JuanCozzi/Trabajo_Final/Informes/propuesta/Imagenes/control_wifi_riego_hunter.PNG

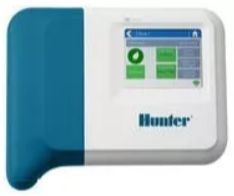
Informes/propuesta/Imagenes/control_wifi_riego_hunter.PNG
