JuanCozzi/Trabajo_Final/Informes/propuesta/Imagenes/modulo_entradas_analogicas.PNG

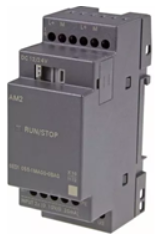
Informes/propuesta/Imagenes/modulo_entradas_analogicas.PNG
