JuanCozzi/Trabajo_Final/README.md

# Trabajo_Final

Trabajo final de Ingeniería Electrónica, Facultad de Ing. UBA

Control de minipiscinas 

Integrantes:
            Bourbon, Rodrigo
            Cozzi, Juan Ignacio
