JuanCozzi/Trabajo_Final/Implementacion/Hardware/pines.jpg

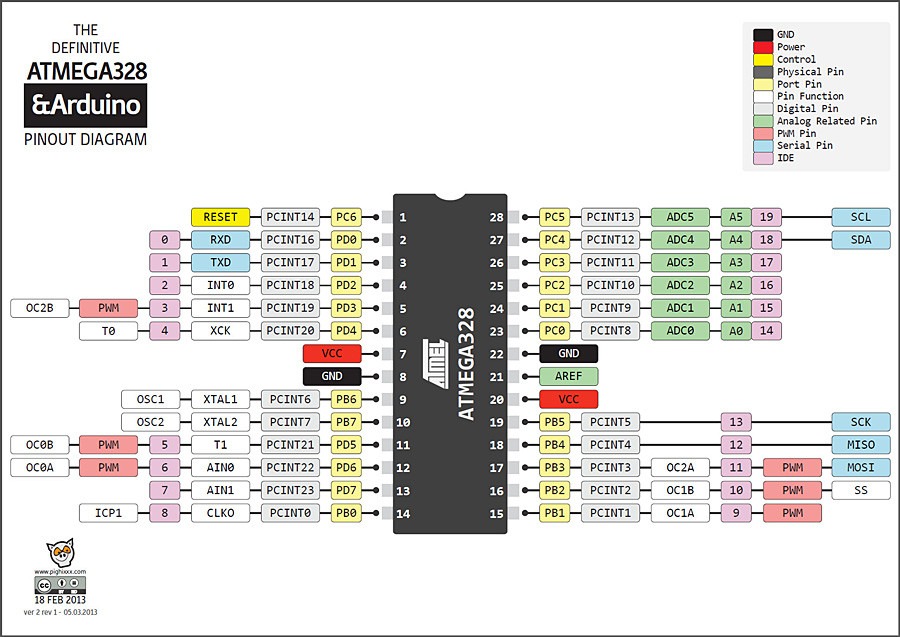
Implementacion/Hardware/pines.jpg
