JuanCozzi/Trabajo_Final/Informes/Imagenes/Final/Bloque_hardware.png

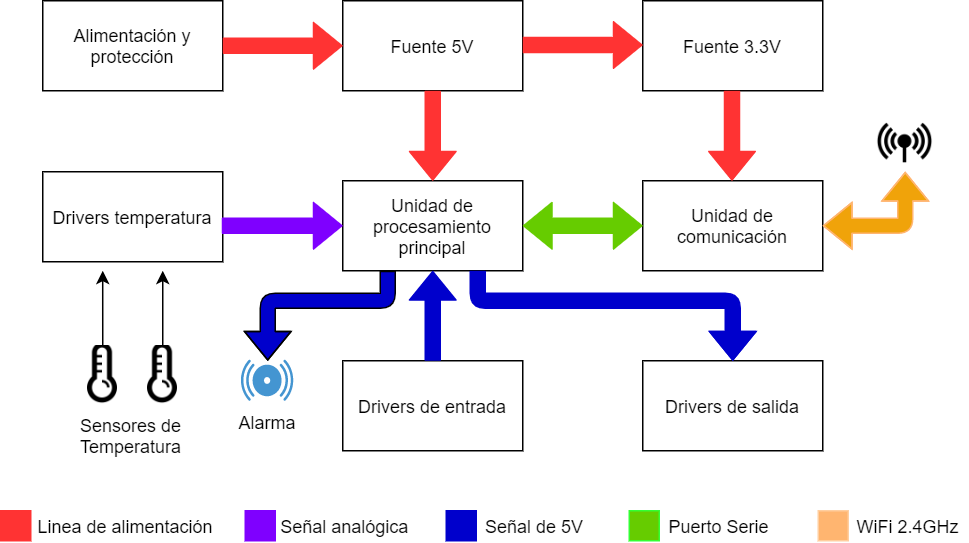
Informes/Imagenes/Final/Bloque_hardware.png
