JuanCozzi/Trabajo_Final/Informes/Imagenes/Final/draw.io/diagrama_flujo_unidad_comunicacion.png

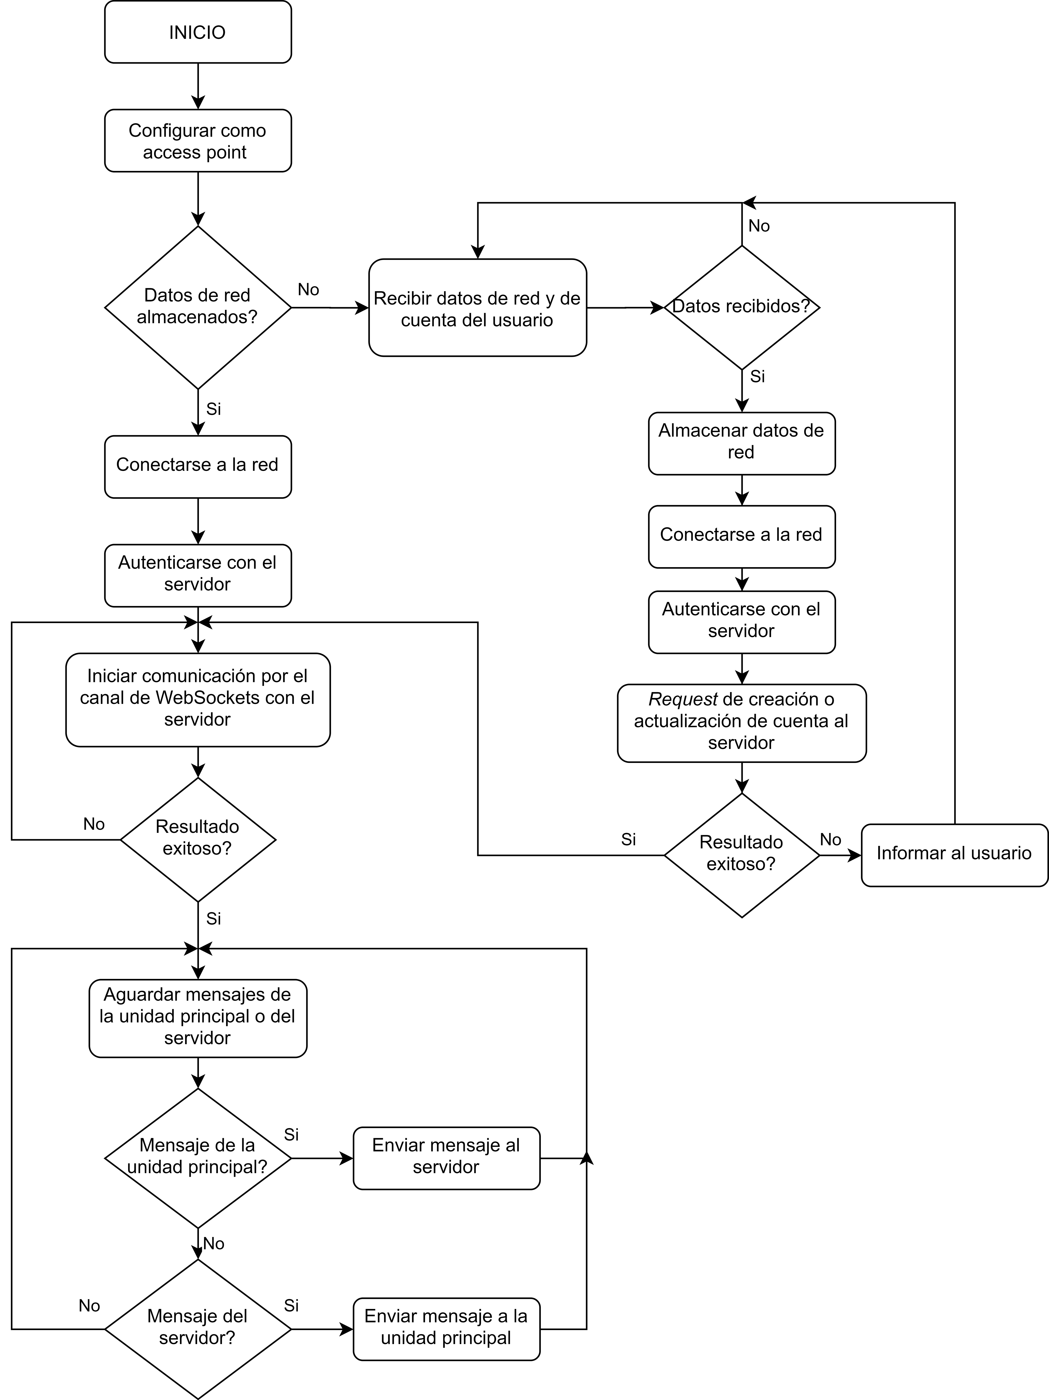
Informes/Imagenes/Final/draw.io/diagrama_flujo_unidad_comunicacion.png
