JuanCozzi/Trabajo_Final/Informes/Imagenes/Final/draw.io/diagrama_flujo_unidad_principal.png

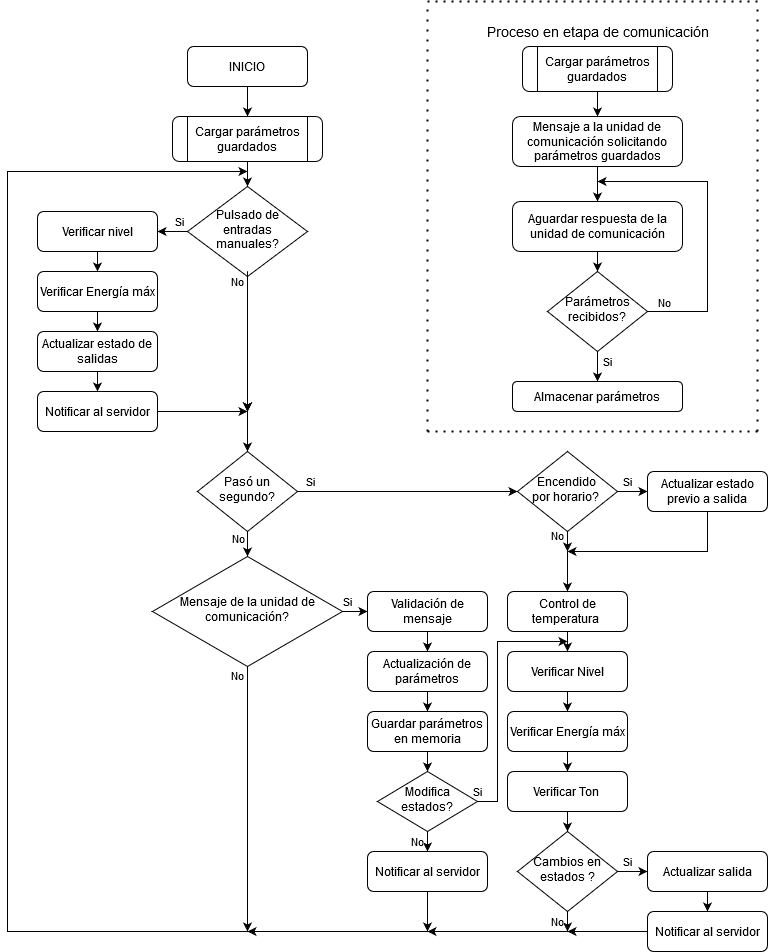
Informes/Imagenes/Final/draw.io/diagrama_flujo_unidad_principal.png
