JuanCozzi/Trabajo_Final/Informes/Imagenes/Final/draw.io/Secuencia2.jpg

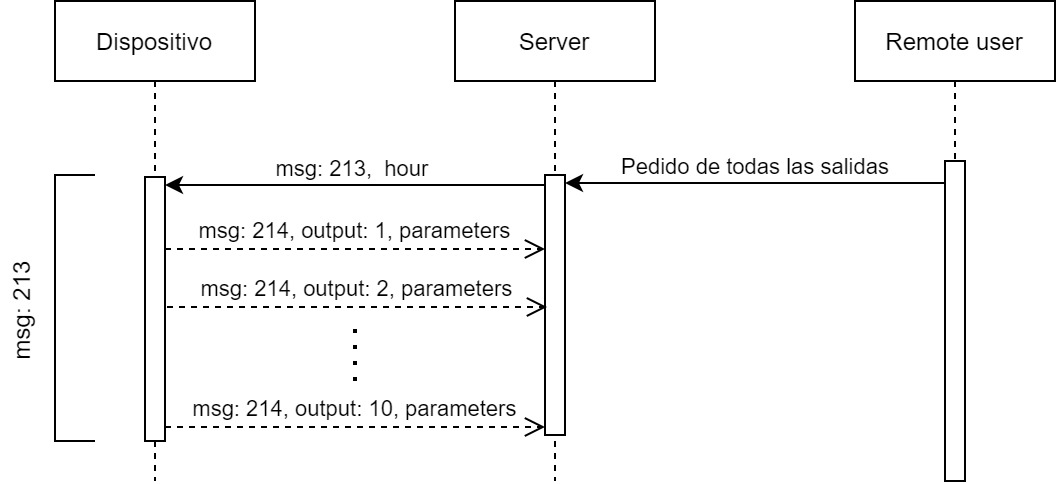
Informes/Imagenes/Final/draw.io/Secuencia2.jpg
