JuanCozzi/Trabajo_Final/Informes/Imagenes/Final/draw.io/Secuencia4.jpg

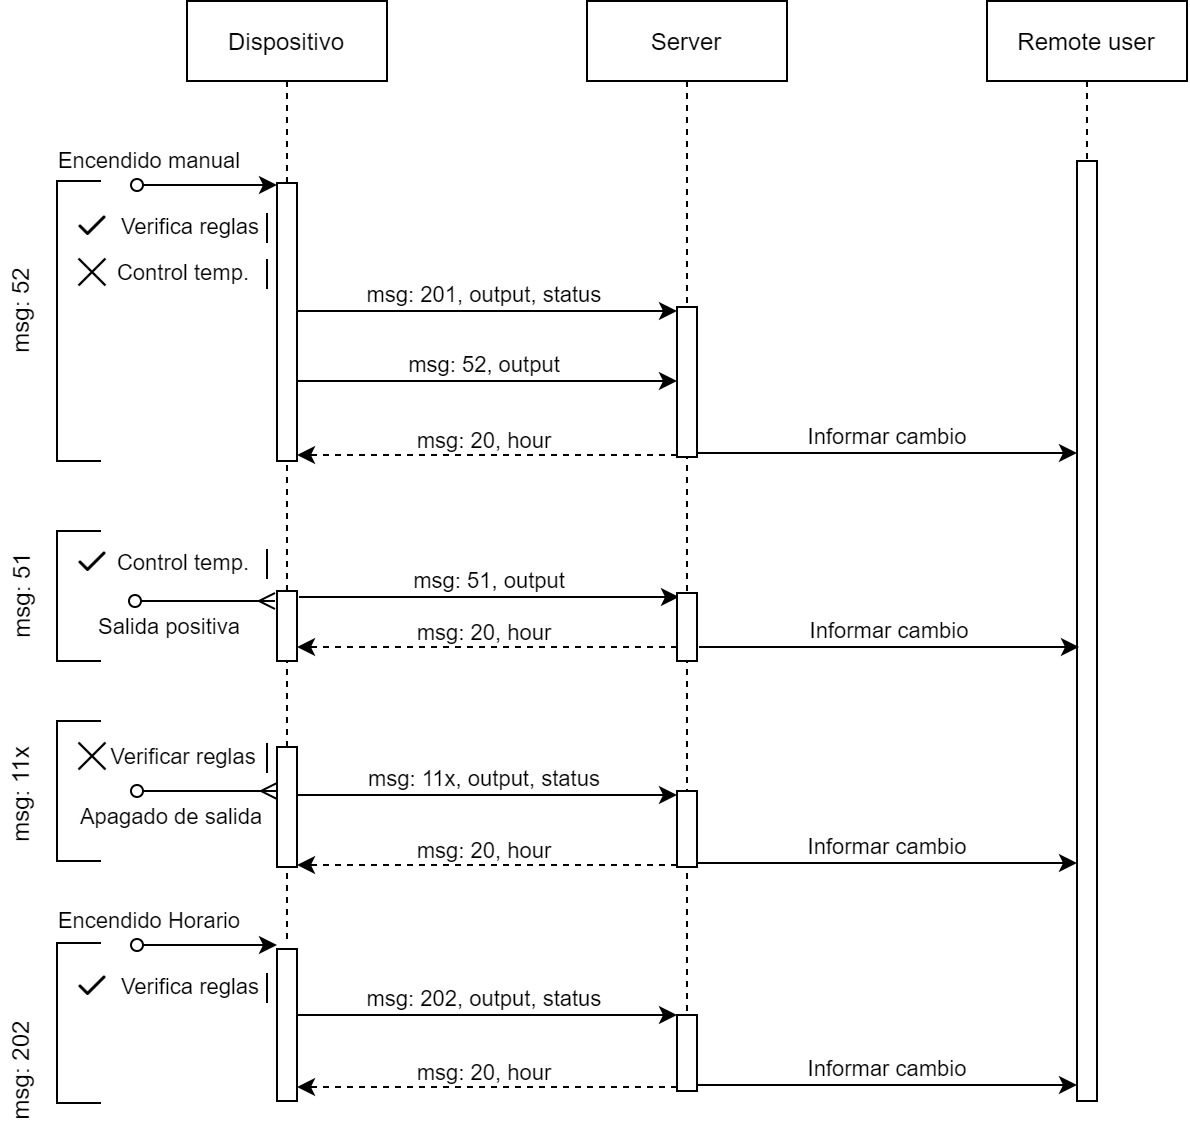
Informes/Imagenes/Final/draw.io/Secuencia4.jpg
