JuanCozzi/Trabajo_Final/Informes/Imagenes/Final/draw.io/Secuencia.jpg

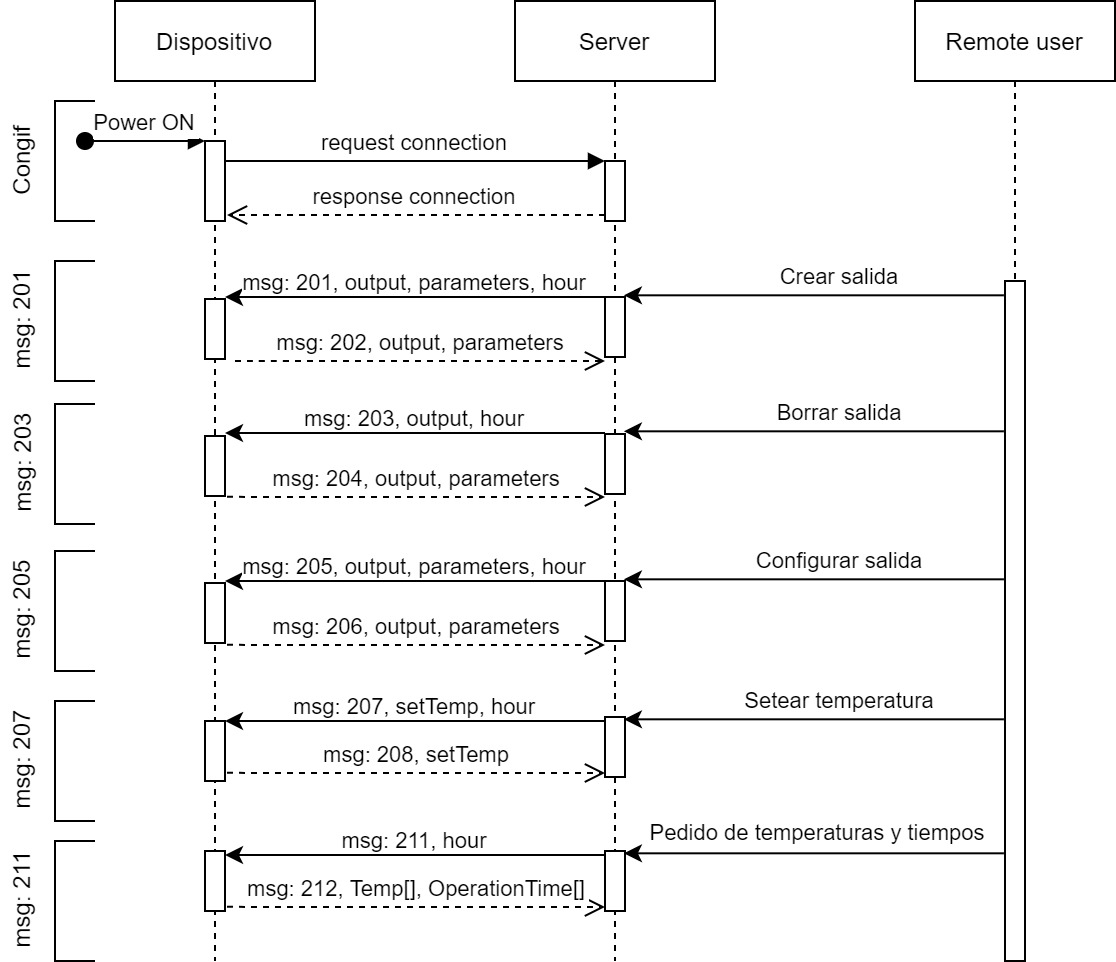
Informes/Imagenes/Final/draw.io/Secuencia.jpg
