JuanCozzi/Trabajo_Final/Informes/Imagenes/Final/draw.io/secuencia_mensajes.png

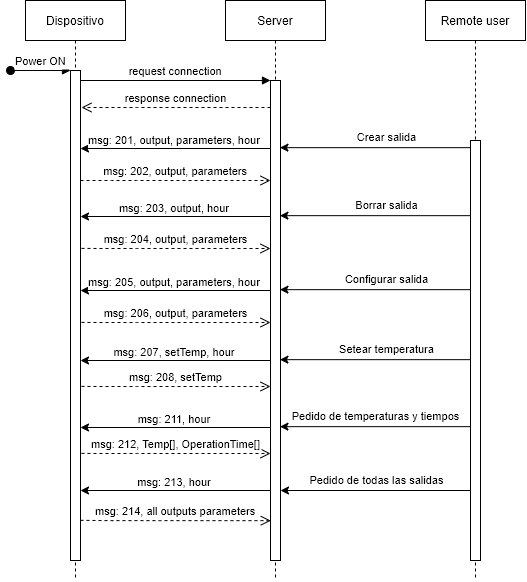
Informes/Imagenes/Final/draw.io/secuencia_mensajes.png
