JuanCozzi/Trabajo_Final/Informes/Imagenes/Final/esquematicos/Atmega.jpg

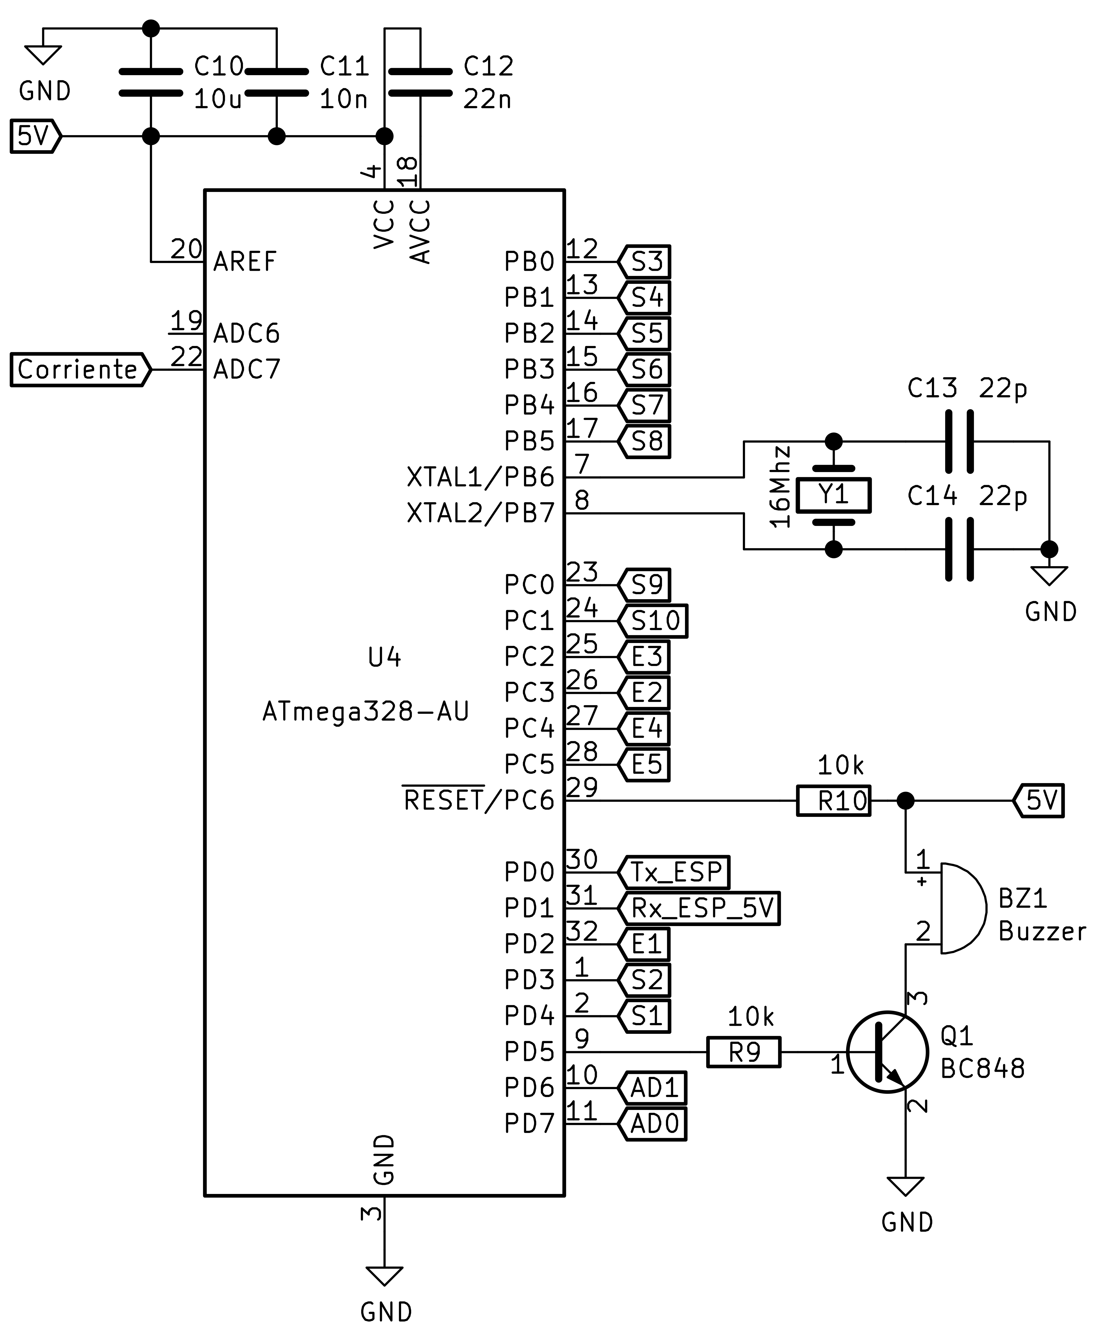
Informes/Imagenes/Final/esquematicos/Atmega.jpg
