JuanCozzi/Trabajo_Final/Informes/Imagenes/Final/esquematicos/Bornera.jpg

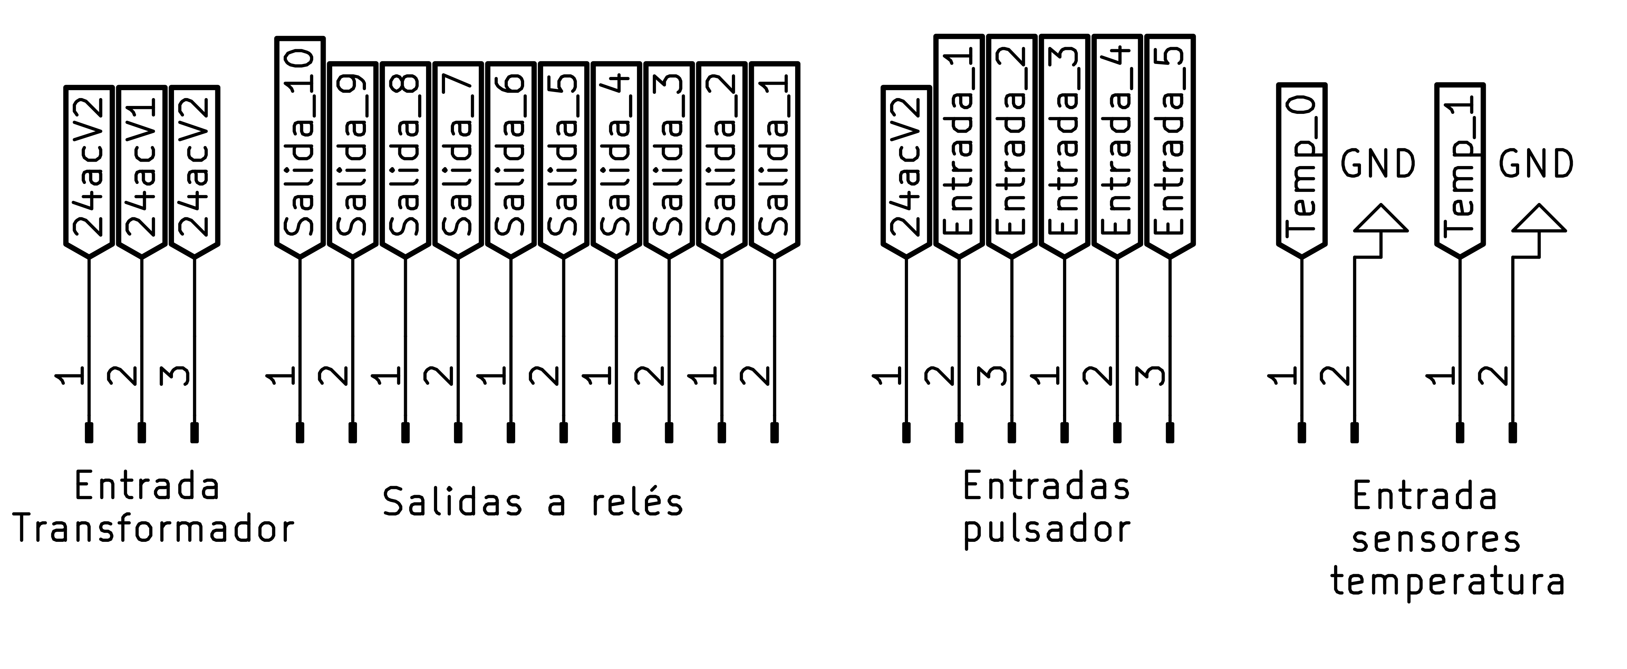
Informes/Imagenes/Final/esquematicos/Bornera.jpg
