JuanCozzi/Trabajo_Final/Informes/Imagenes/Final/esquematicos/Driver_entrada.jpg

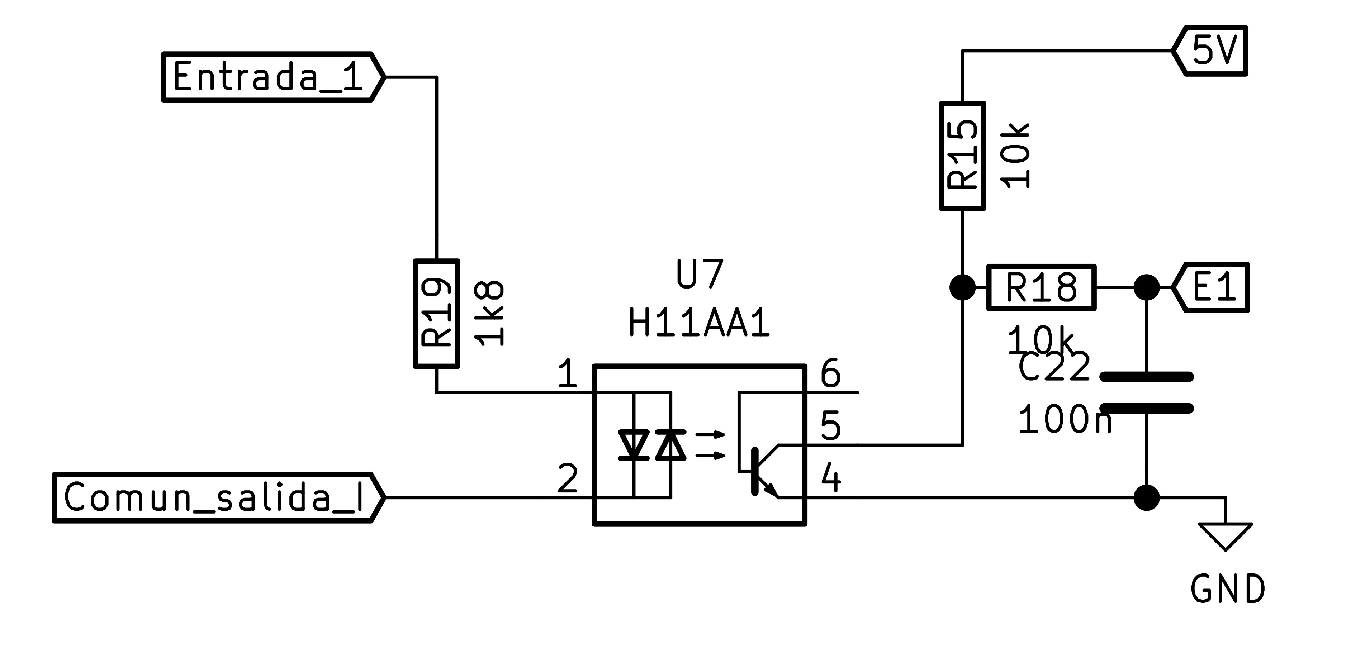
Informes/Imagenes/Final/esquematicos/Driver_entrada.jpg
