JuanCozzi/Trabajo_Final/Informes/Imagenes/Final/esquematicos/Driver_salida.jpg

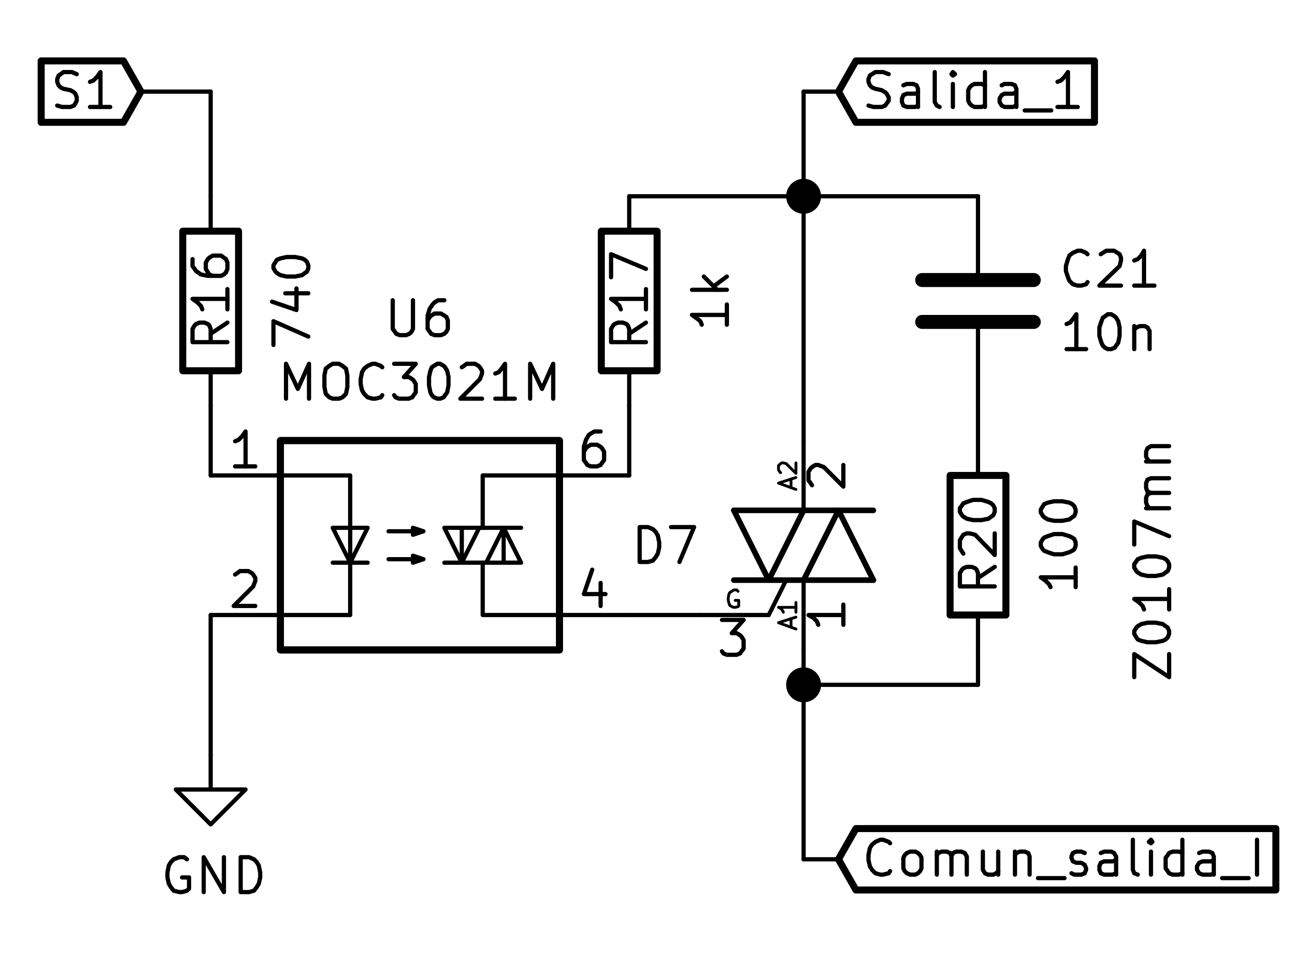
Informes/Imagenes/Final/esquematicos/Driver_salida.jpg
