JuanCozzi/Trabajo_Final/Informes/Imagenes/Final/esquematicos/Esp.jpg

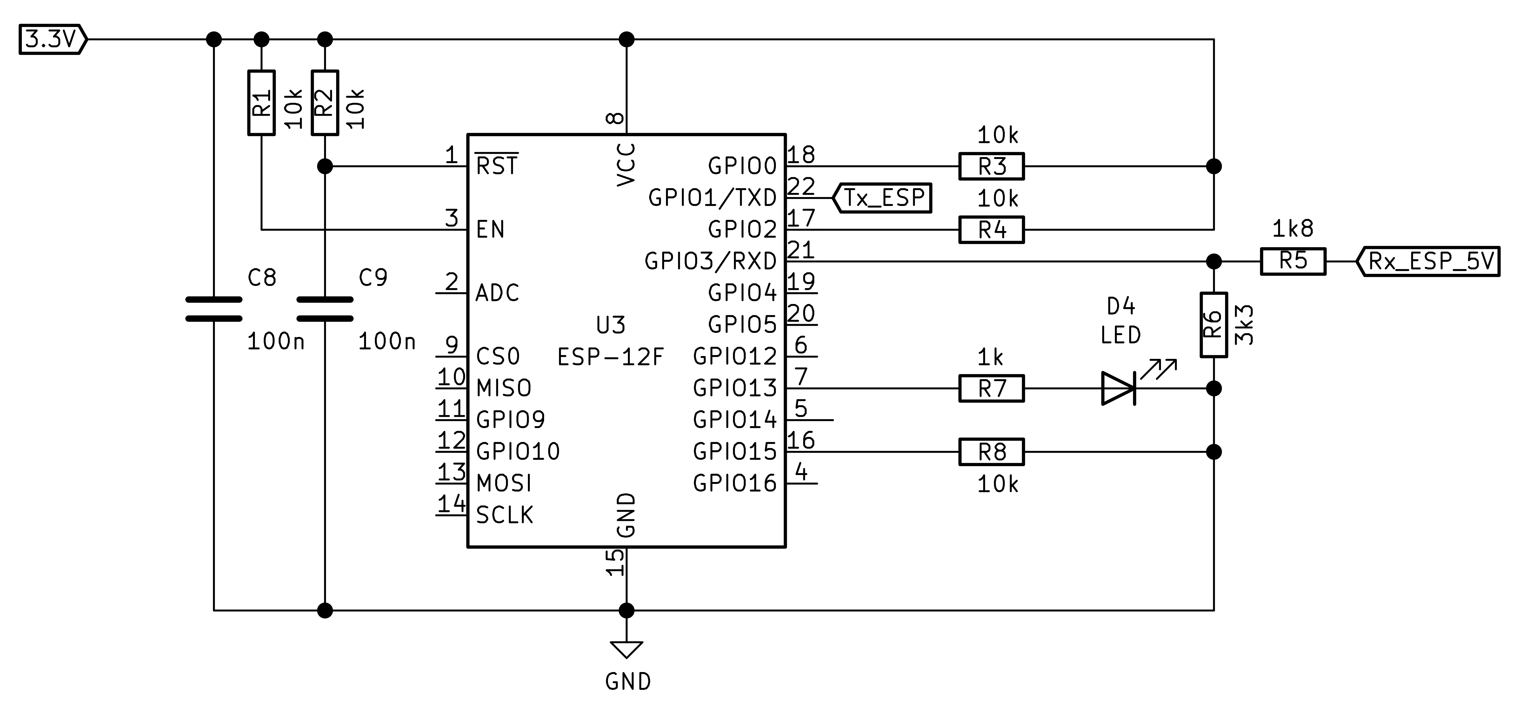
Informes/Imagenes/Final/esquematicos/Esp.jpg
