JuanCozzi/Trabajo_Final/Informes/Imagenes/Final/esquematicos/Fuente.jpg

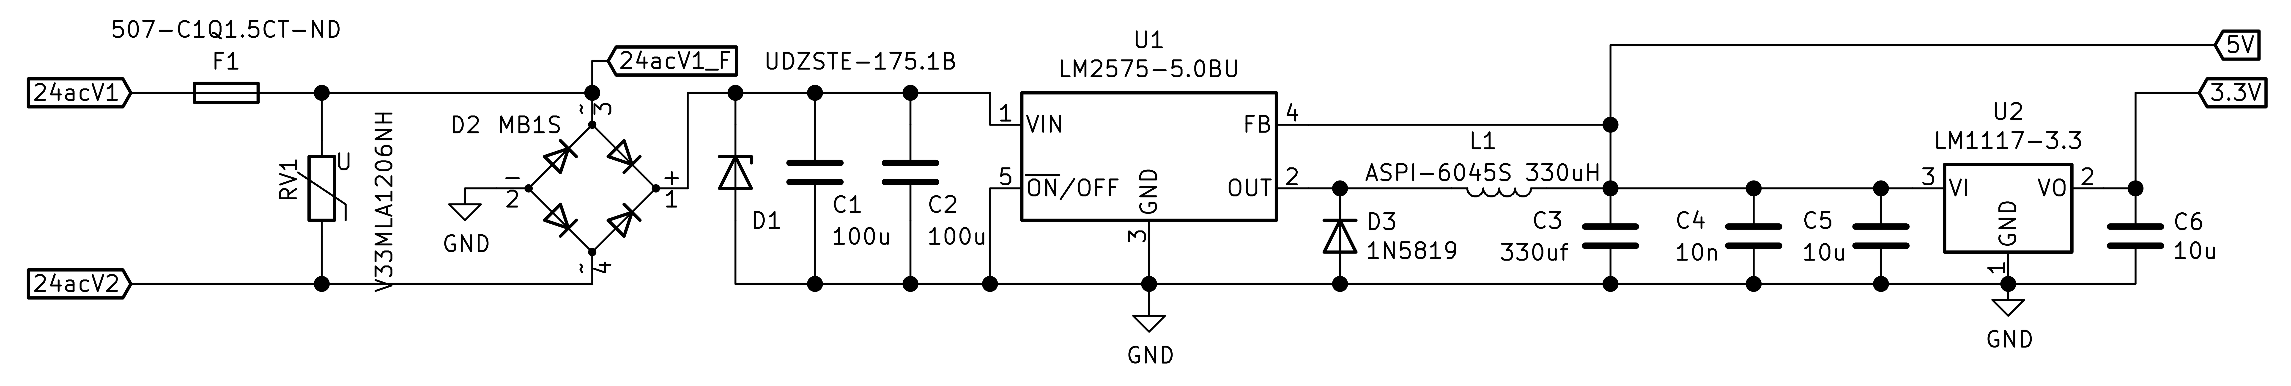
Informes/Imagenes/Final/esquematicos/Fuente.jpg
