JuanCozzi/Trabajo_Final/Informes/Imagenes/Final/esquematicos/Protección.jpg

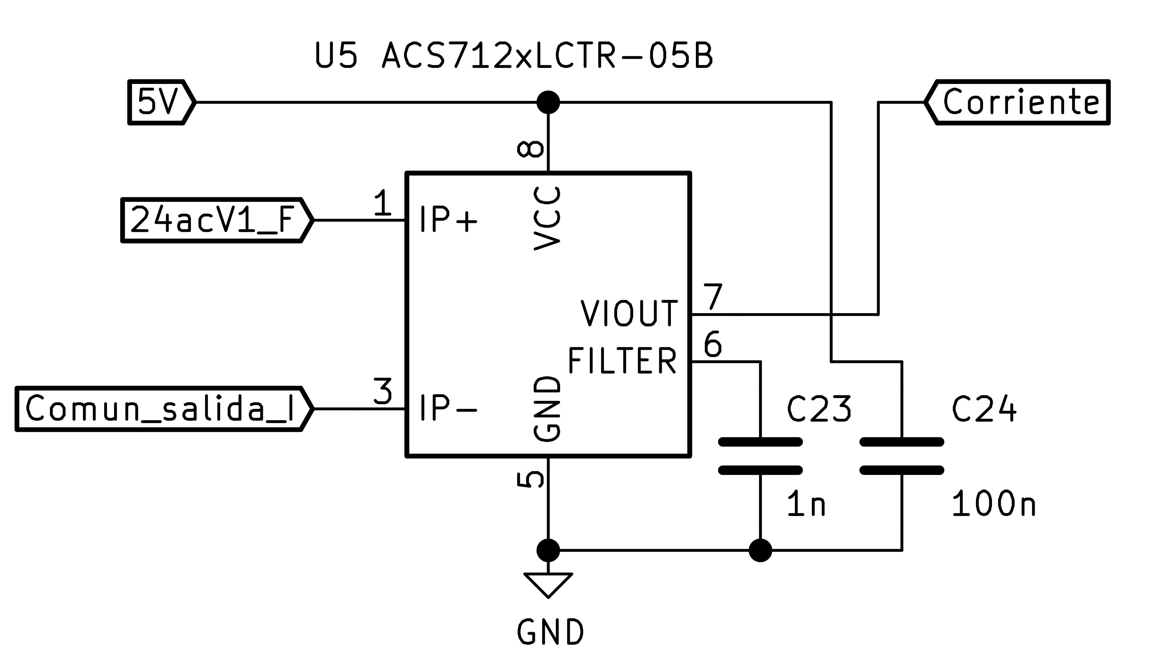
Informes/Imagenes/Final/esquematicos/Protección.jpg
