JuanCozzi/Trabajo_Final/Informes/Imagenes/Final/esquematicos/Temp.jpg

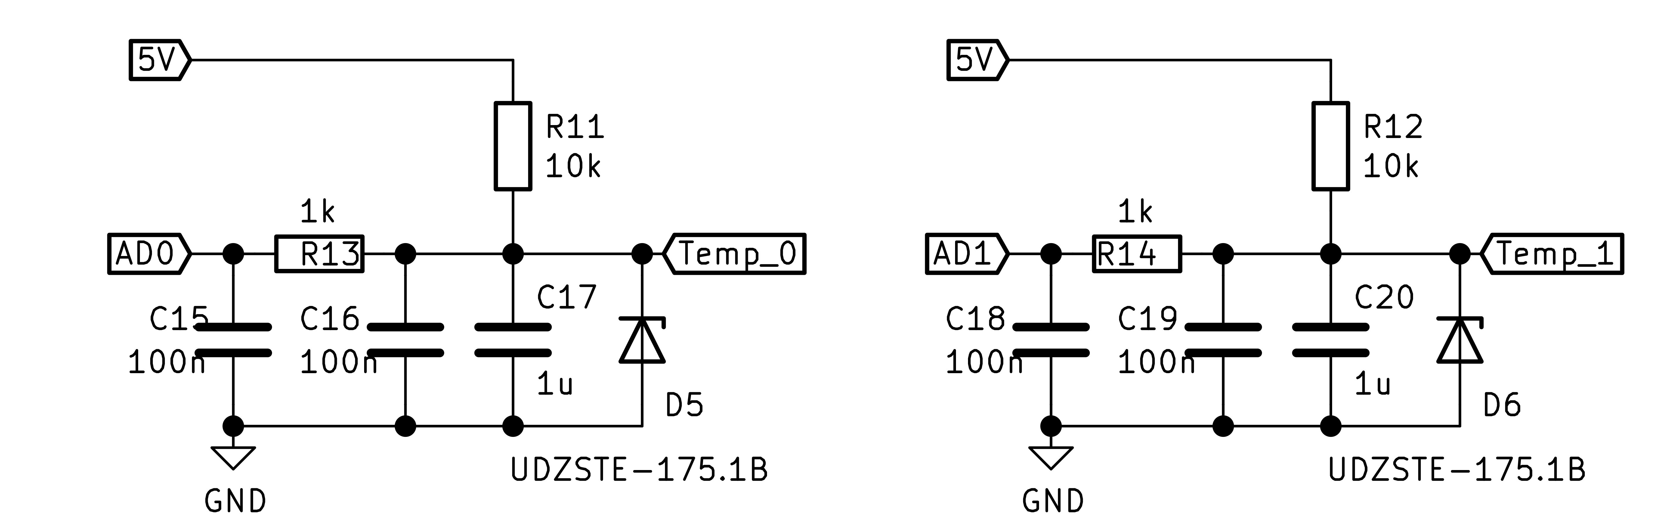
Informes/Imagenes/Final/esquematicos/Temp.jpg
