JuanCozzi/Trabajo_Final/Informes/Imagenes/Final/PCB/3D.jpg

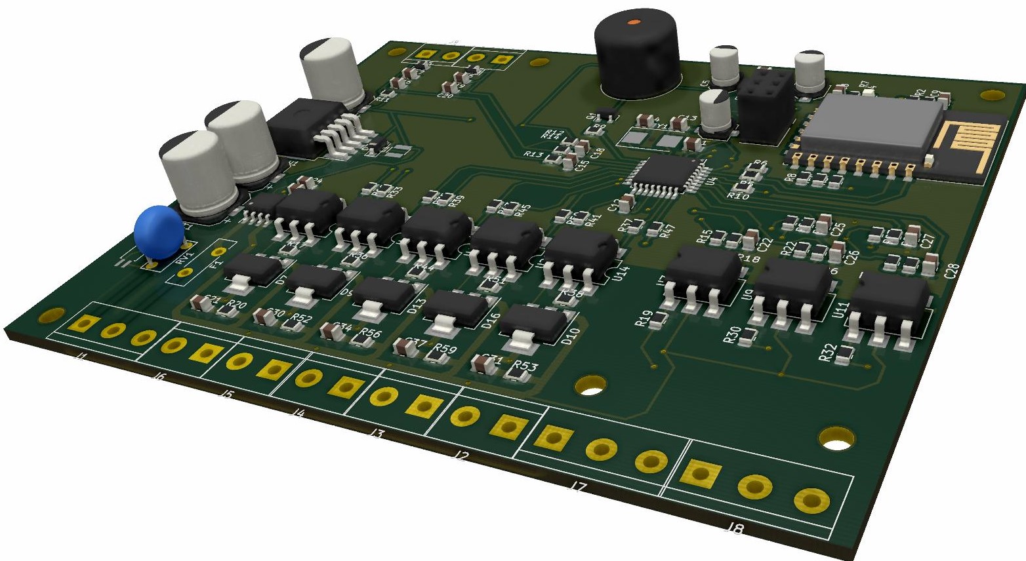
Informes/Imagenes/Final/PCB/3D.jpg
