JuanCozzi/Trabajo_Final/Informes/Imagenes/Final/PCB/Final_1-B_Cu.jpg

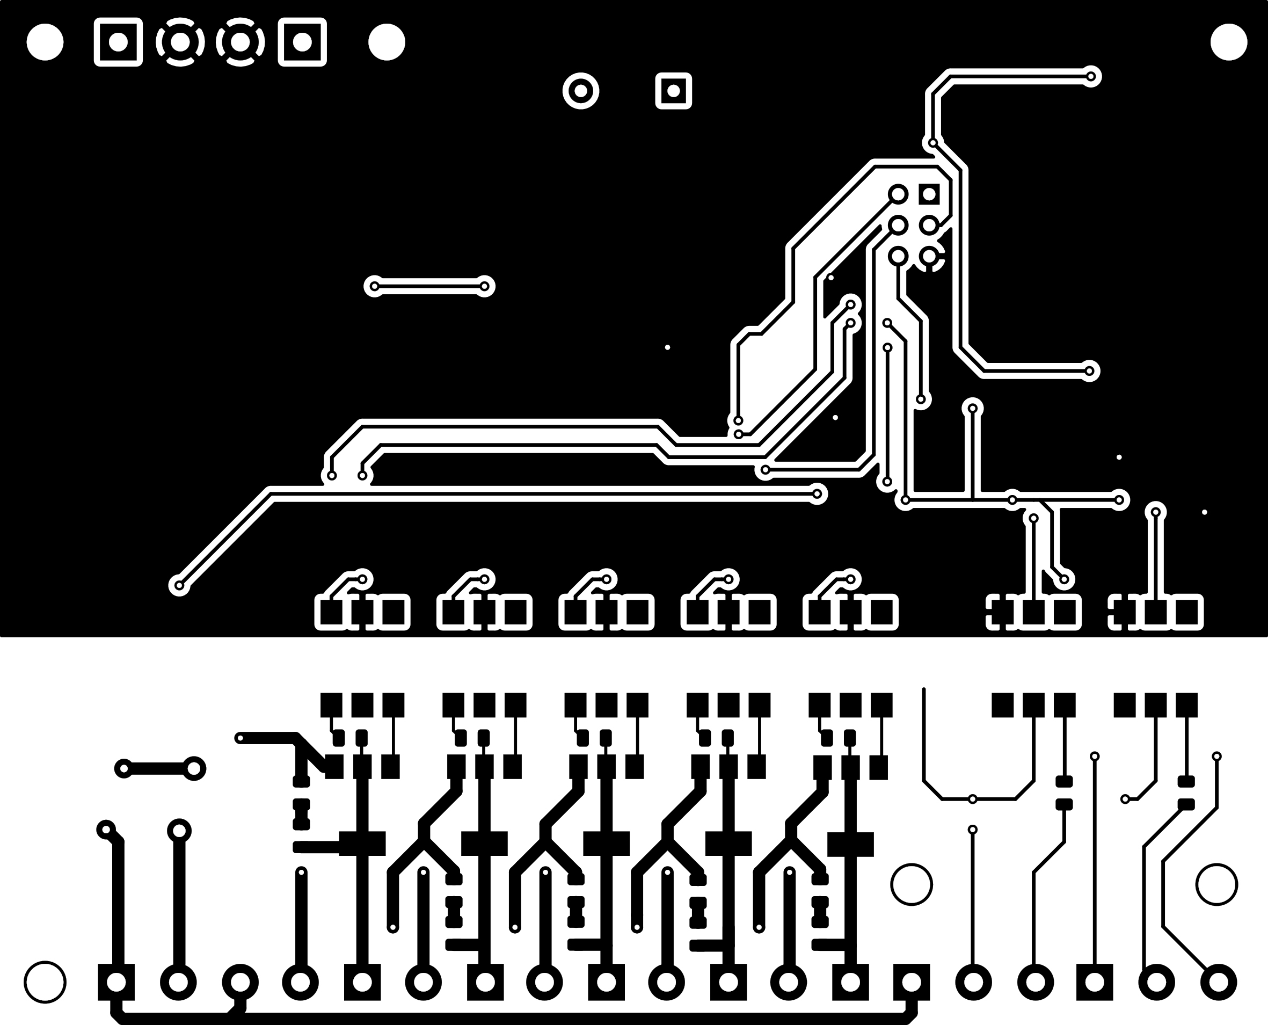
Informes/Imagenes/Final/PCB/Final_1-B_Cu.jpg
