JuanCozzi/Trabajo_Final/Informes/Imagenes/Final/PCB/Final_1-F_Cu.jpg

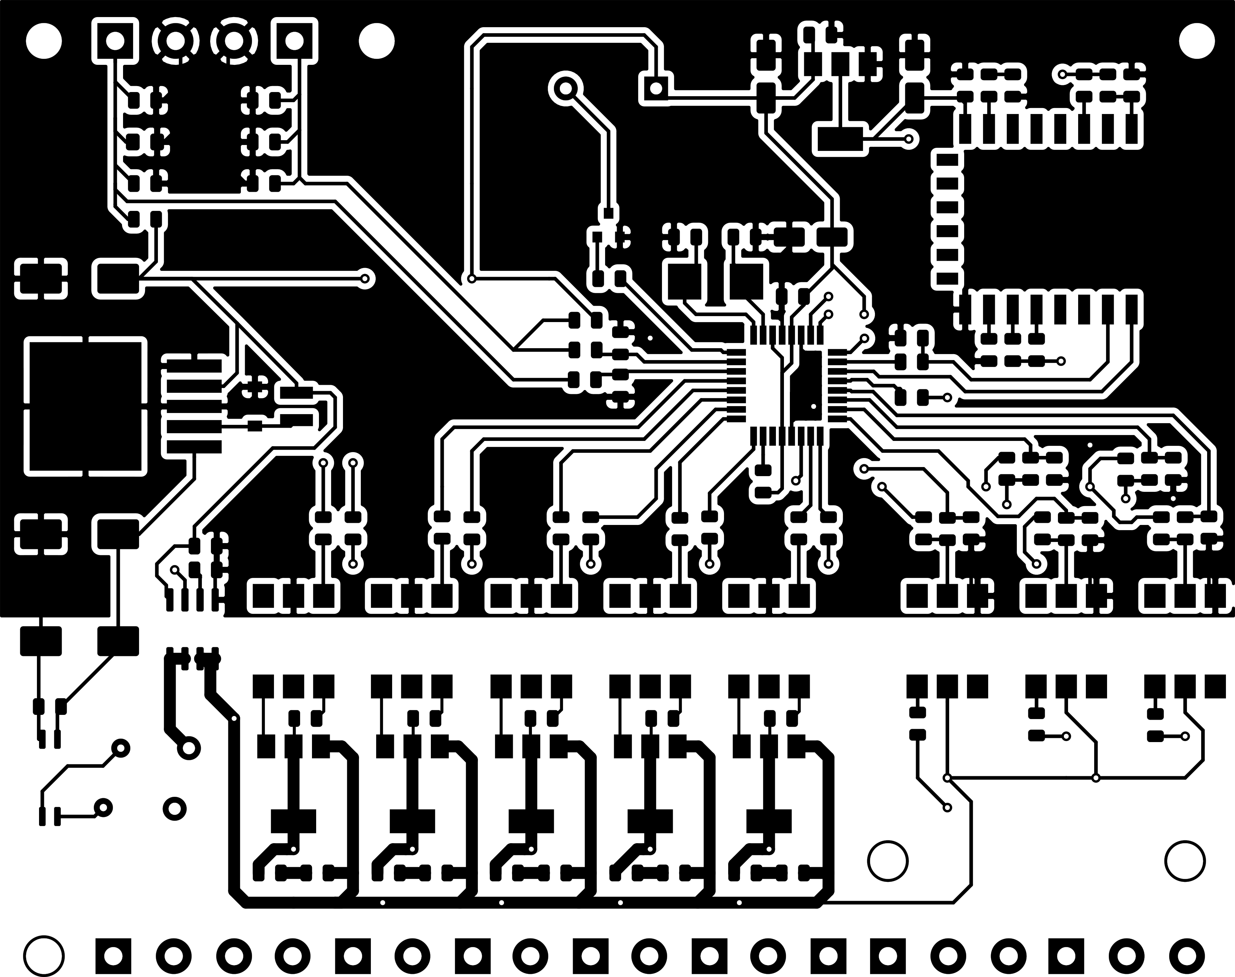
Informes/Imagenes/Final/PCB/Final_1-F_Cu.jpg
