JuanCozzi/Trabajo_Final/Informes/propuesta/Imagenes/ciclo_vida.PNG

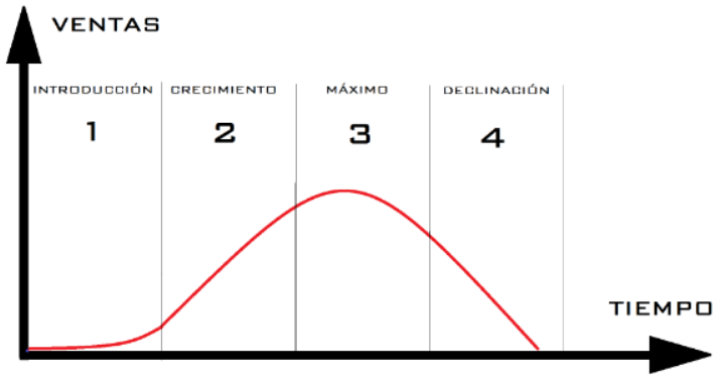
Informes/propuesta/Imagenes/ciclo_vida.PNG
