JuanCozzi/Trabajo_Final/Informes/propuesta/Imagenes/control_riego_hunter.PNG

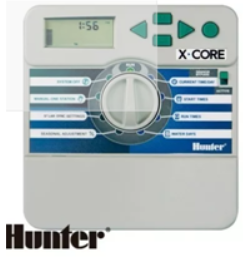
Informes/propuesta/Imagenes/control_riego_hunter.PNG
