JuanCozzi/Trabajo_Final/Informes/propuesta/Imagenes/gantt.png

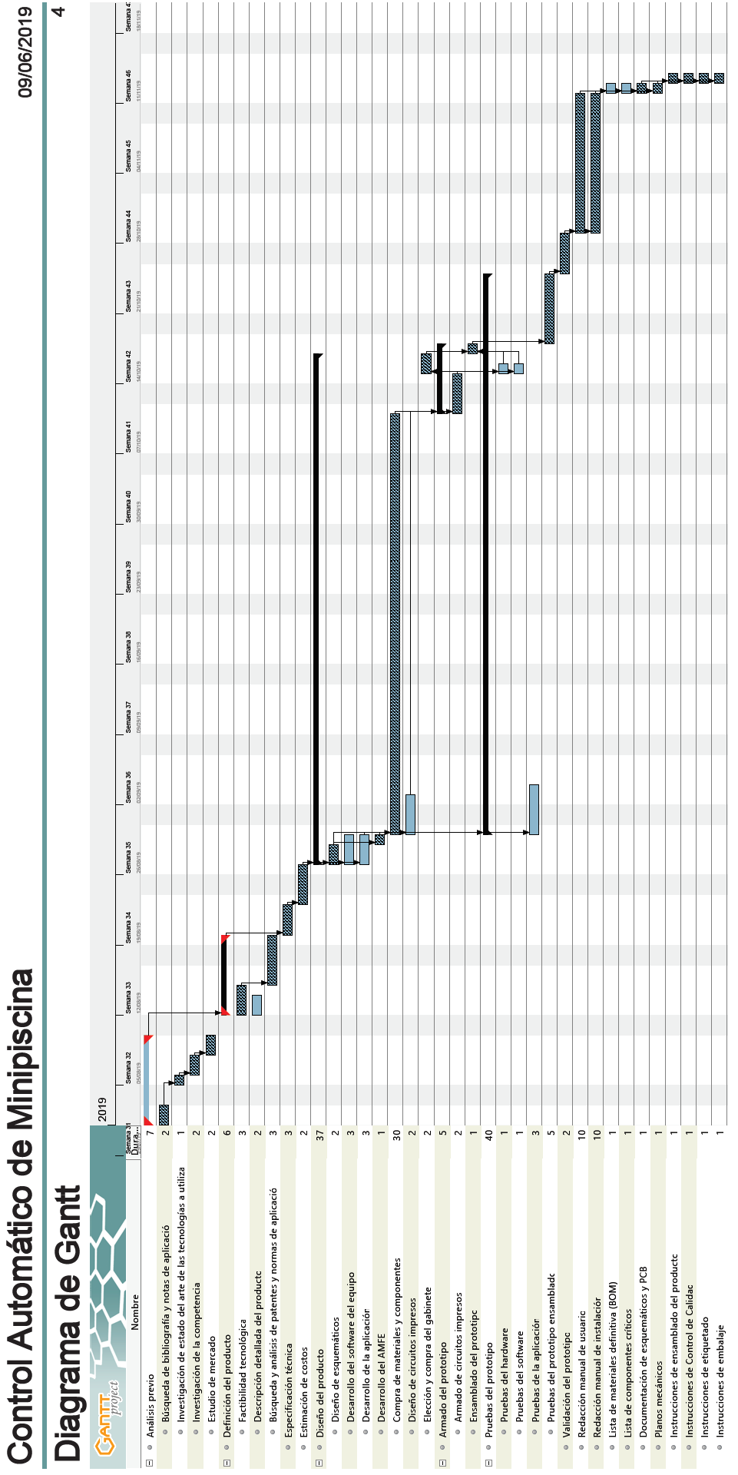
Informes/propuesta/Imagenes/gantt.png
