JuanCozzi/Trabajo_Final/Informes/propuesta/Imagenes/gantt_lista.PNG

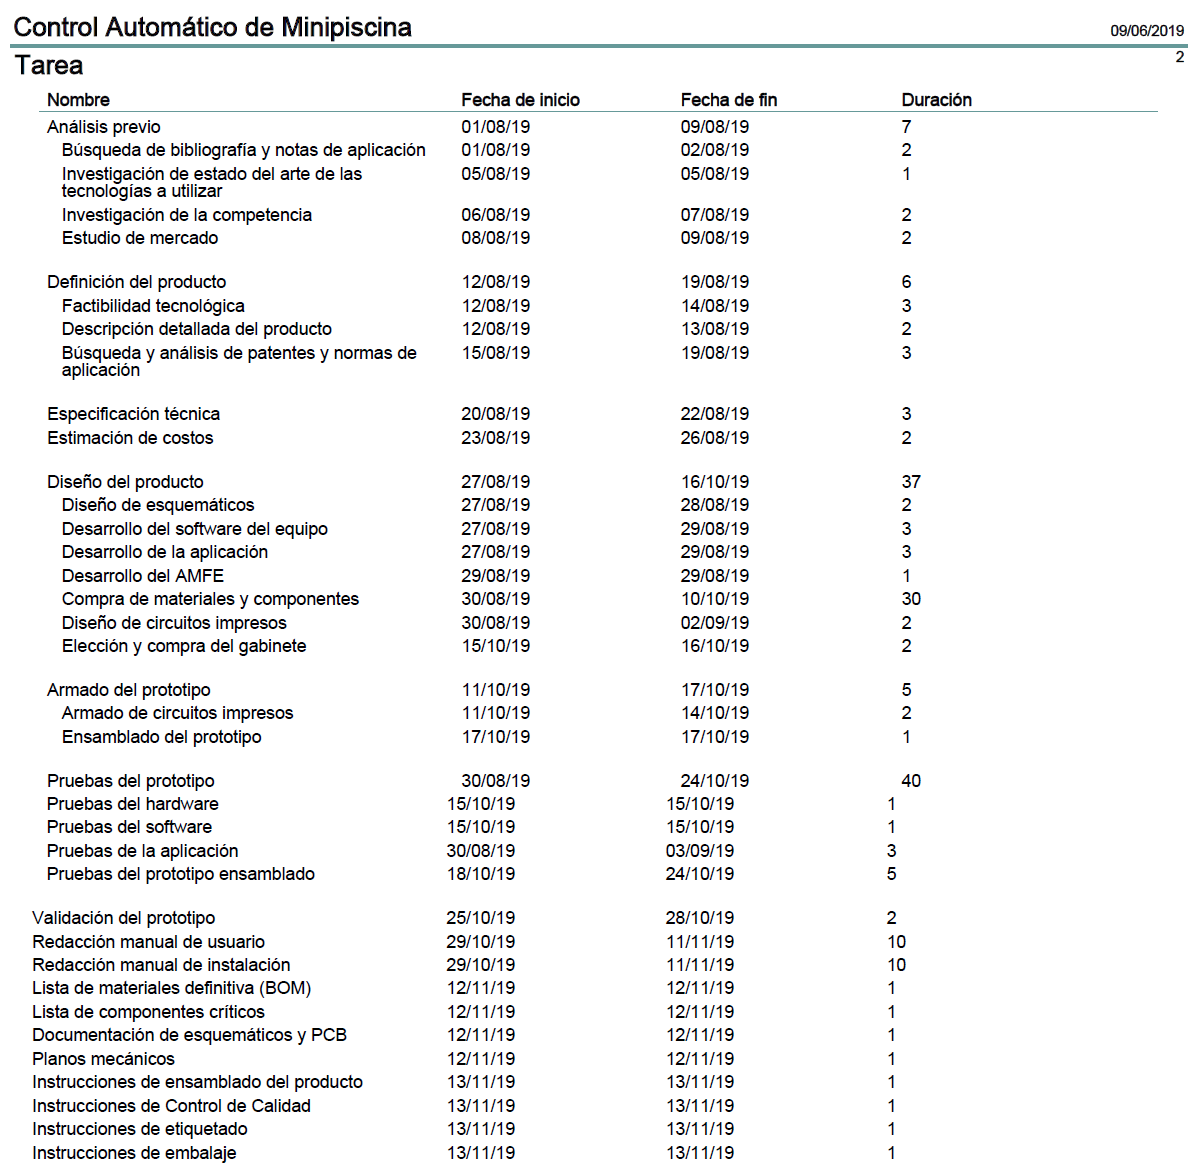
Informes/propuesta/Imagenes/gantt_lista.PNG
