JuanCozzi/Trabajo_Final/Informes/propuesta/Imagenes/rele_timer.PNG

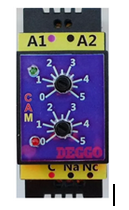
Informes/propuesta/Imagenes/rele_timer.PNG
