JuanCozzi/Trabajo_Final/(list of files, cad)

Other CAD files:
Implementacion/Planos/Gabinete.dwg
Implementacion/Planos/PCB.dwg
Implementacion/Planos/Montaje.dwg
