JuanCozzi/Trabajo_Final/Informes/Imagenes/Final/Montaje/Gabinete.jpg

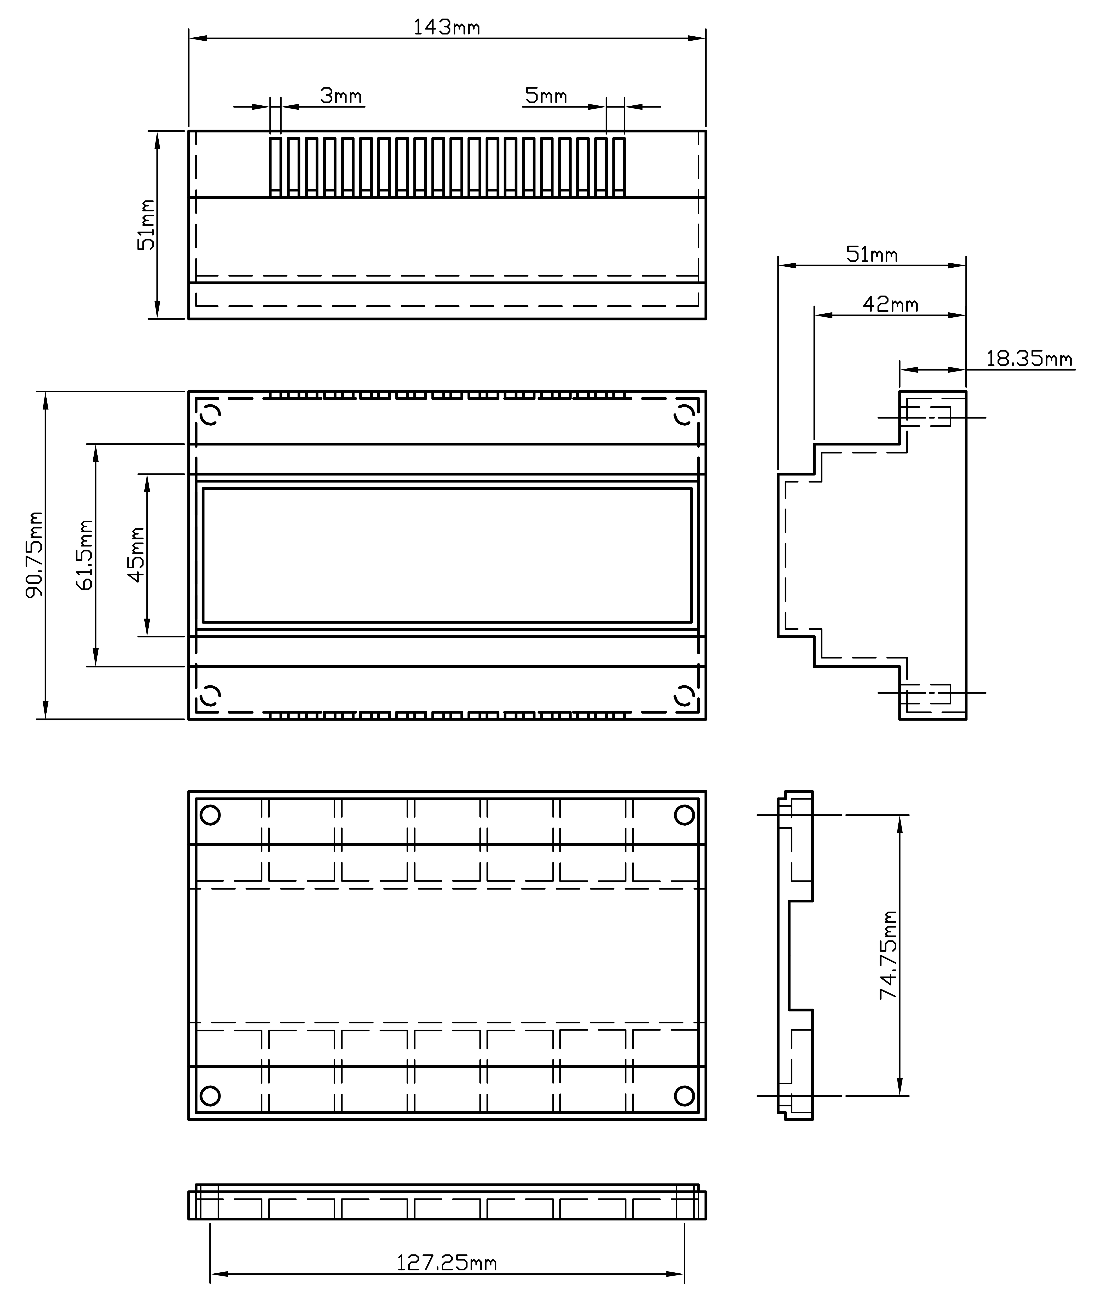
Informes/Imagenes/Final/Montaje/Gabinete.jpg
