JuanCozzi/Trabajo_Final/Informes/Imagenes/Final/Montaje/gabinete_3d.png

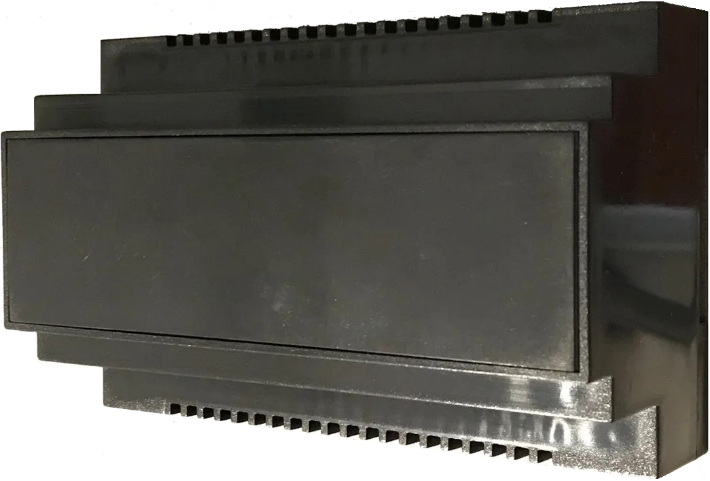
Informes/Imagenes/Final/Montaje/gabinete_3d.png
