JuanCozzi/Trabajo_Final/Informes/Imagenes/Final/Montaje/Montaje_desarrollo.jpg

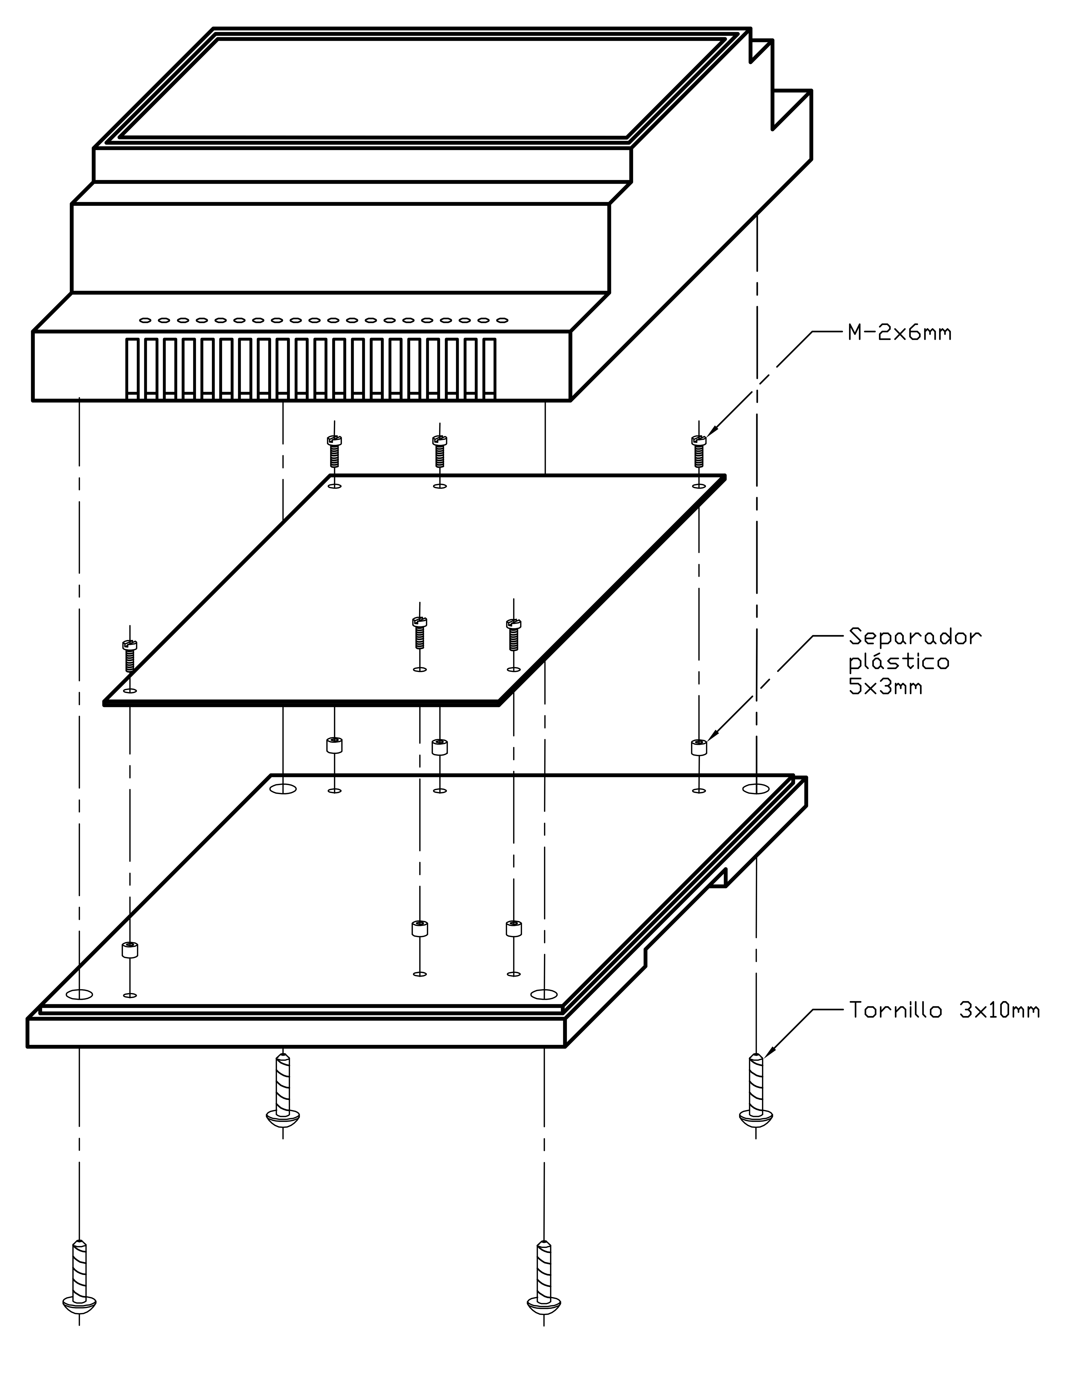
Informes/Imagenes/Final/Montaje/Montaje_desarrollo.jpg
