JuanCozzi/Trabajo_Final/Implementacion/Planos/Montaje_desarrollo.pdf

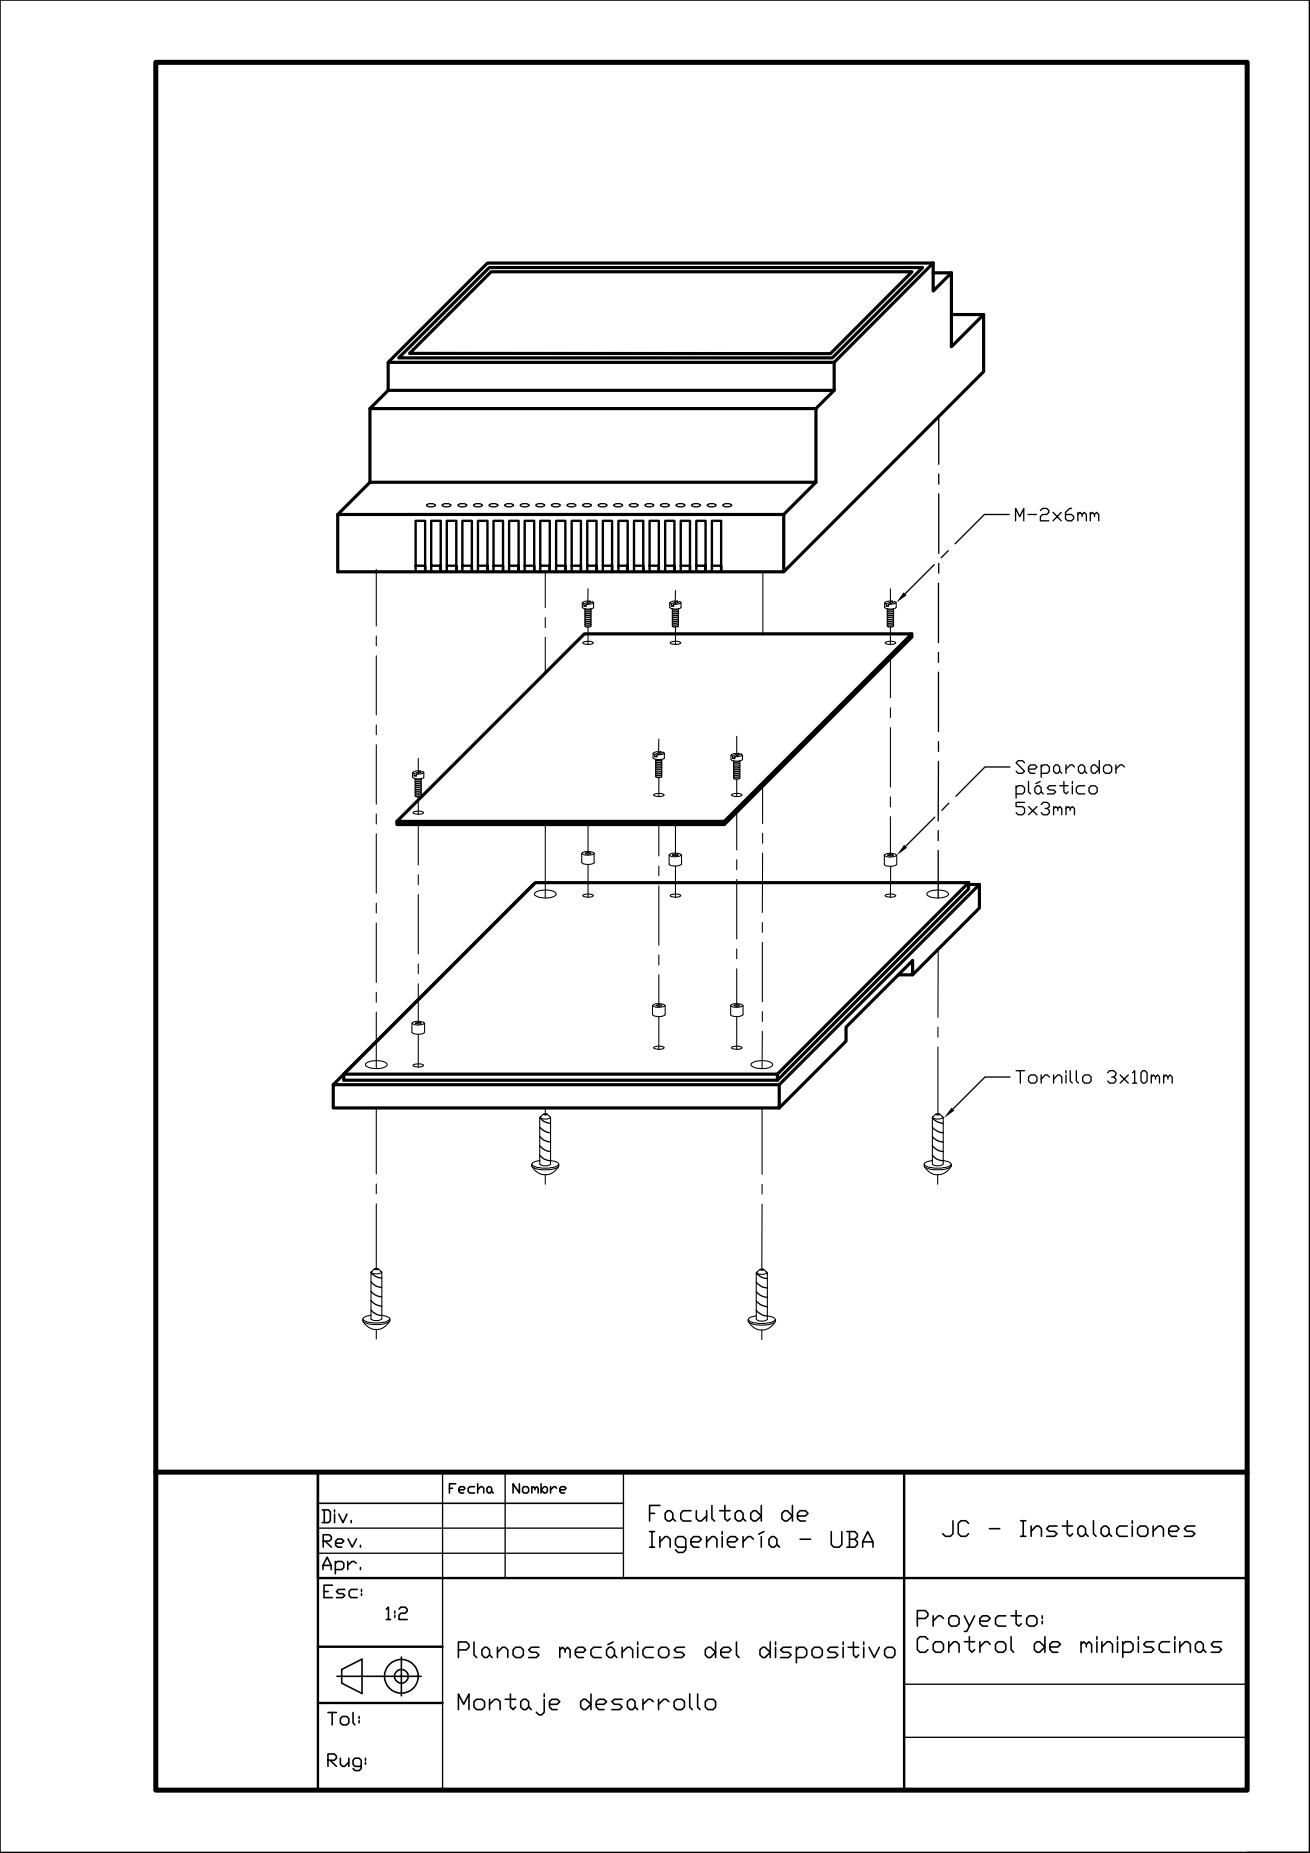
[picture p83: page 1]
