JuanCozzi/Trabajo_Final/Implementacion/Hardware/PCB/Final_1-B_Cu.pdf

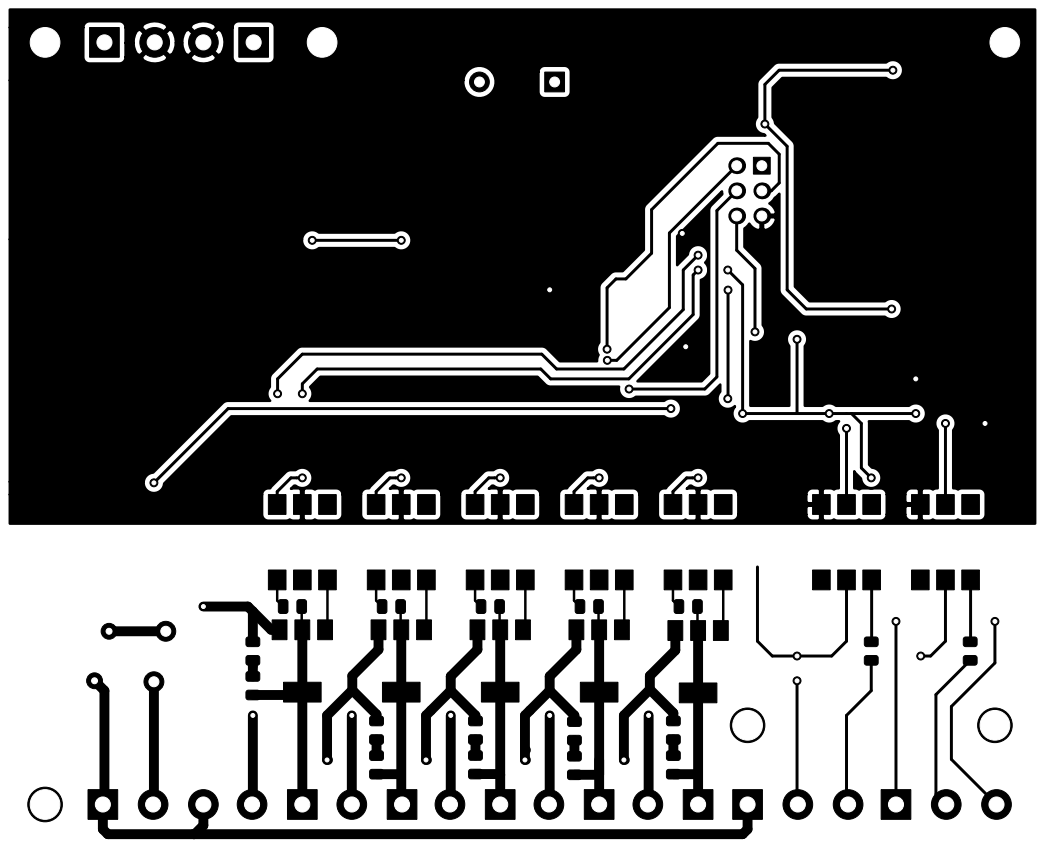
[picture p84: page 1]
