JuanCozzi/Trabajo_Final/Implementacion/Hardware/PCB/Final_1-F_Cu.pdf

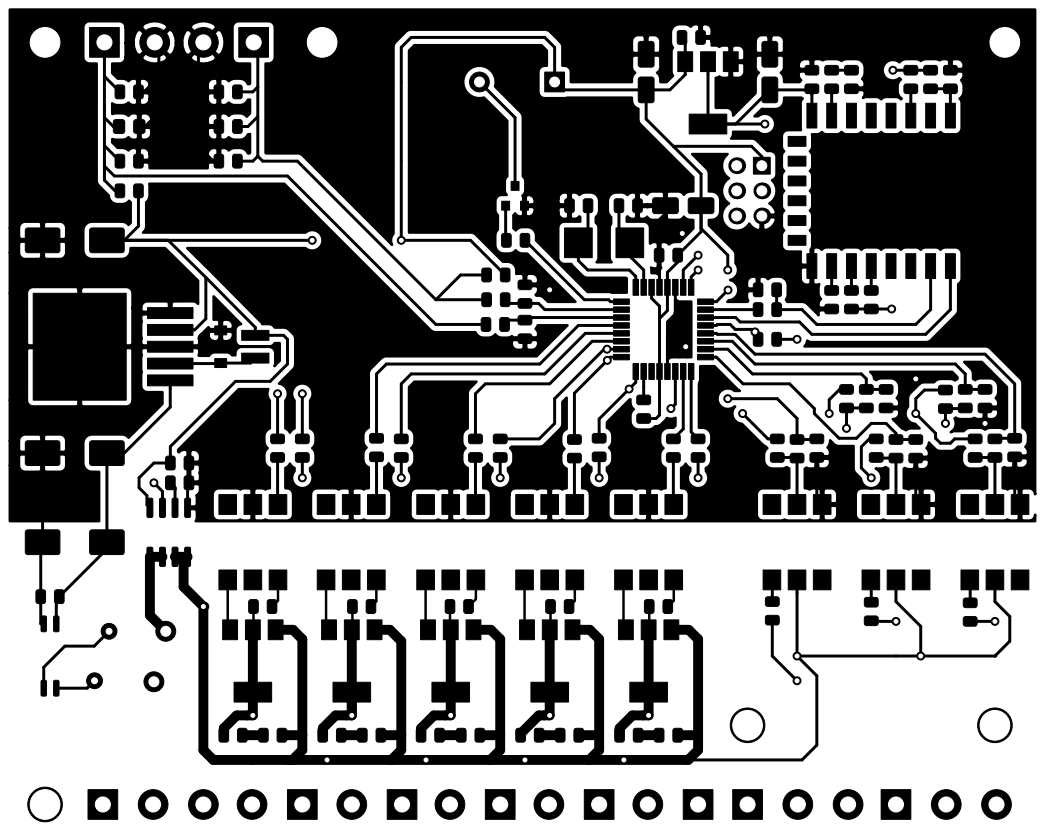
[picture p85: page 1]
