JuanCozzi/Trabajo_Final/Implementacion/Hardware/PCB/Final_1-F_Mask.pdf

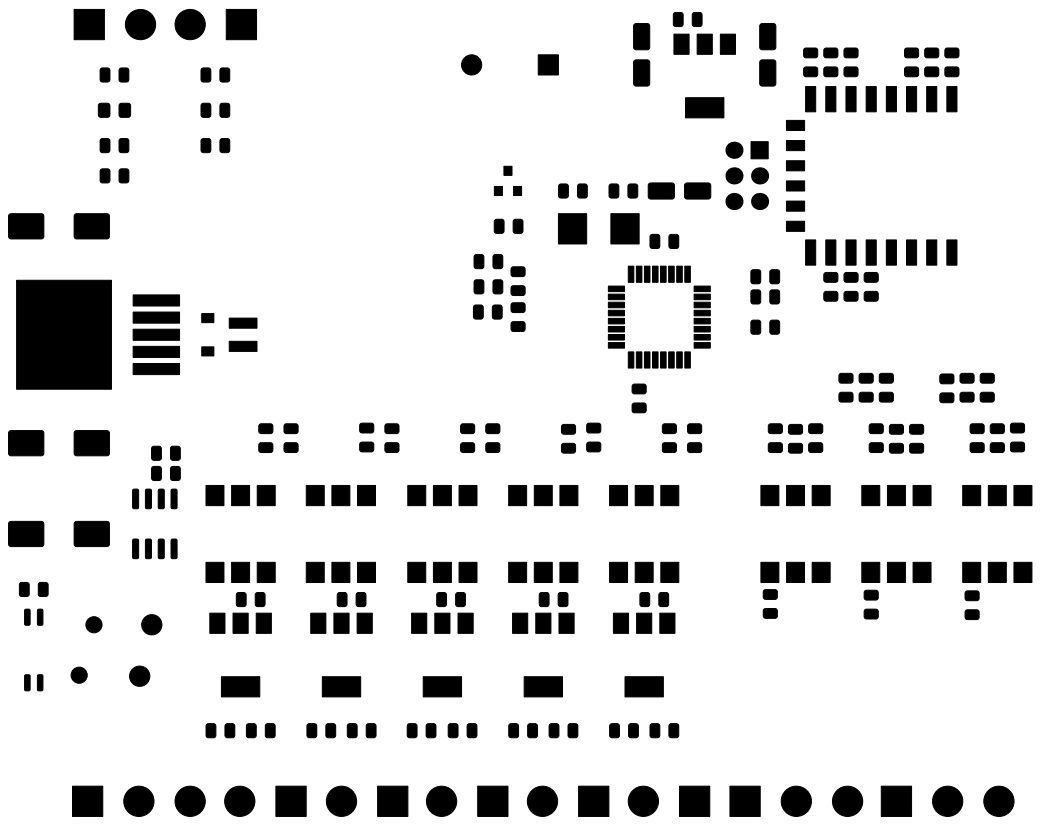
[picture p86: page 1]
