JuanCozzi/Trabajo_Final/Implementacion/Hardware/PCB/Final_1-F_Paste.pdf

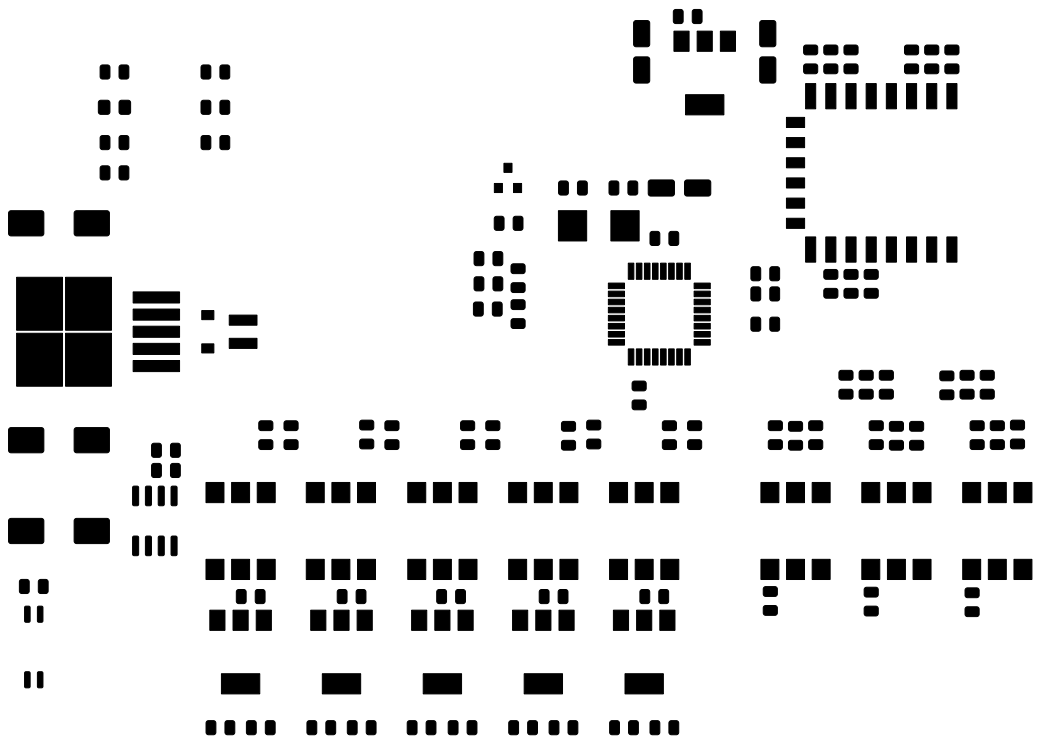
[picture p87: page 1]
