JuanCozzi/Trabajo_Final/Implementacion/Hardware/PCB/Final_1-F_SilkS.pdf

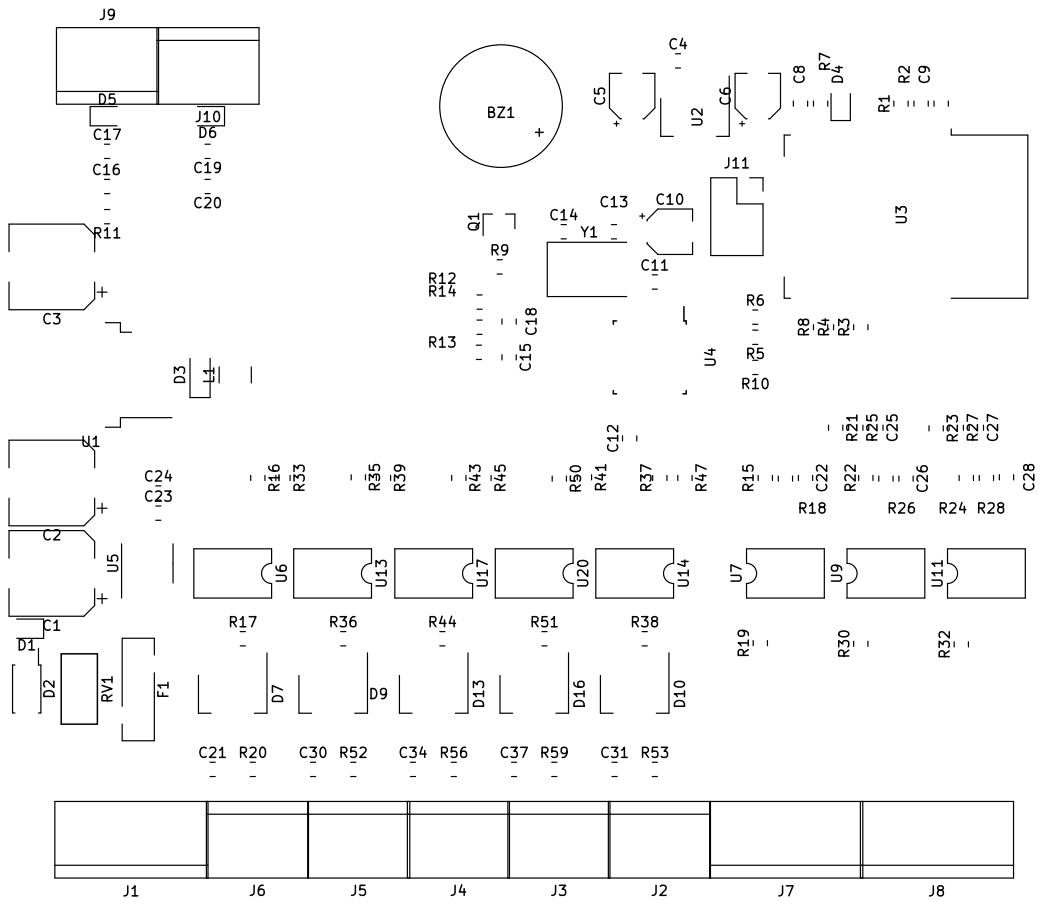
[picture p88: page 1]
