JuanCozzi/Trabajo_Final/Implementacion/Hardware/PCB/final_front.pdf

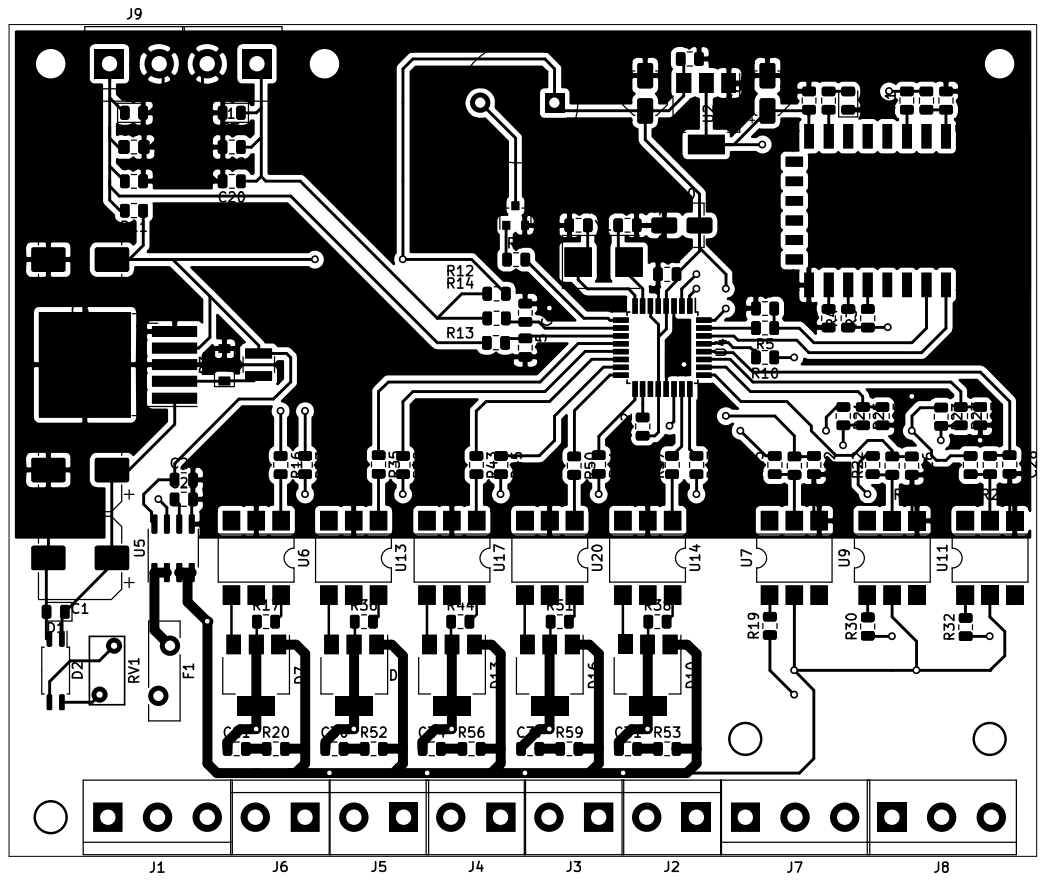
[picture p89: page 1]
