JuanCozzi/Trabajo_Final/Implementacion/Hardware/PCB/Final_1.pdf

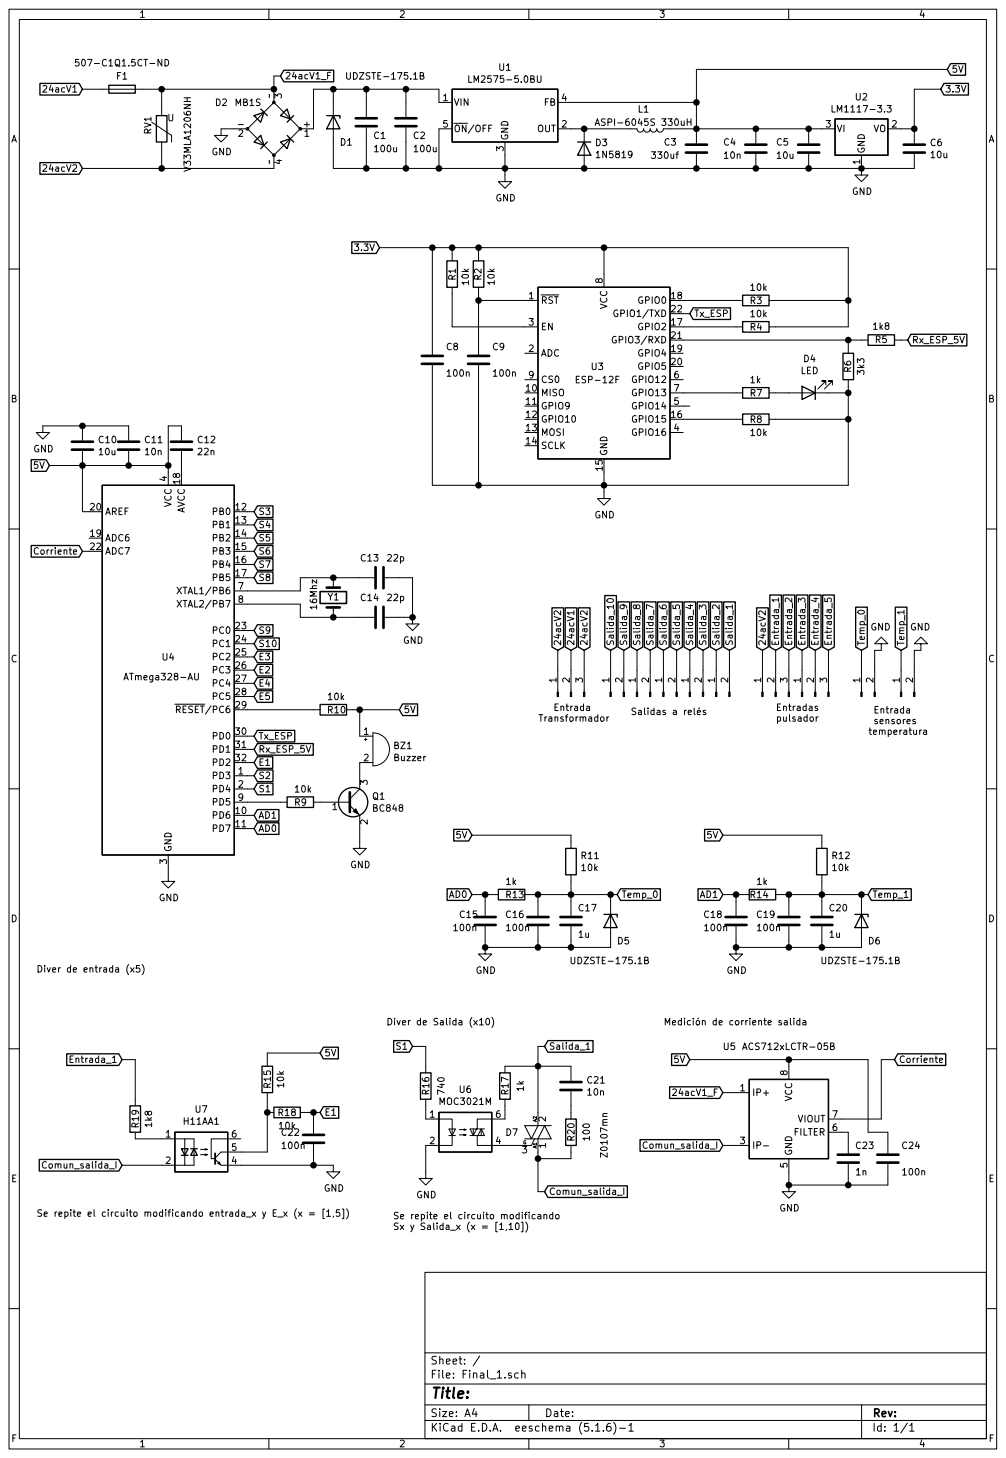
[picture p90: page 1]

Medición de corriente salida
