JuanCozzi/Trabajo_Final/Implementacion/Hardware/Hojas de datos/terminal block/OSTVNXXA150.pdf

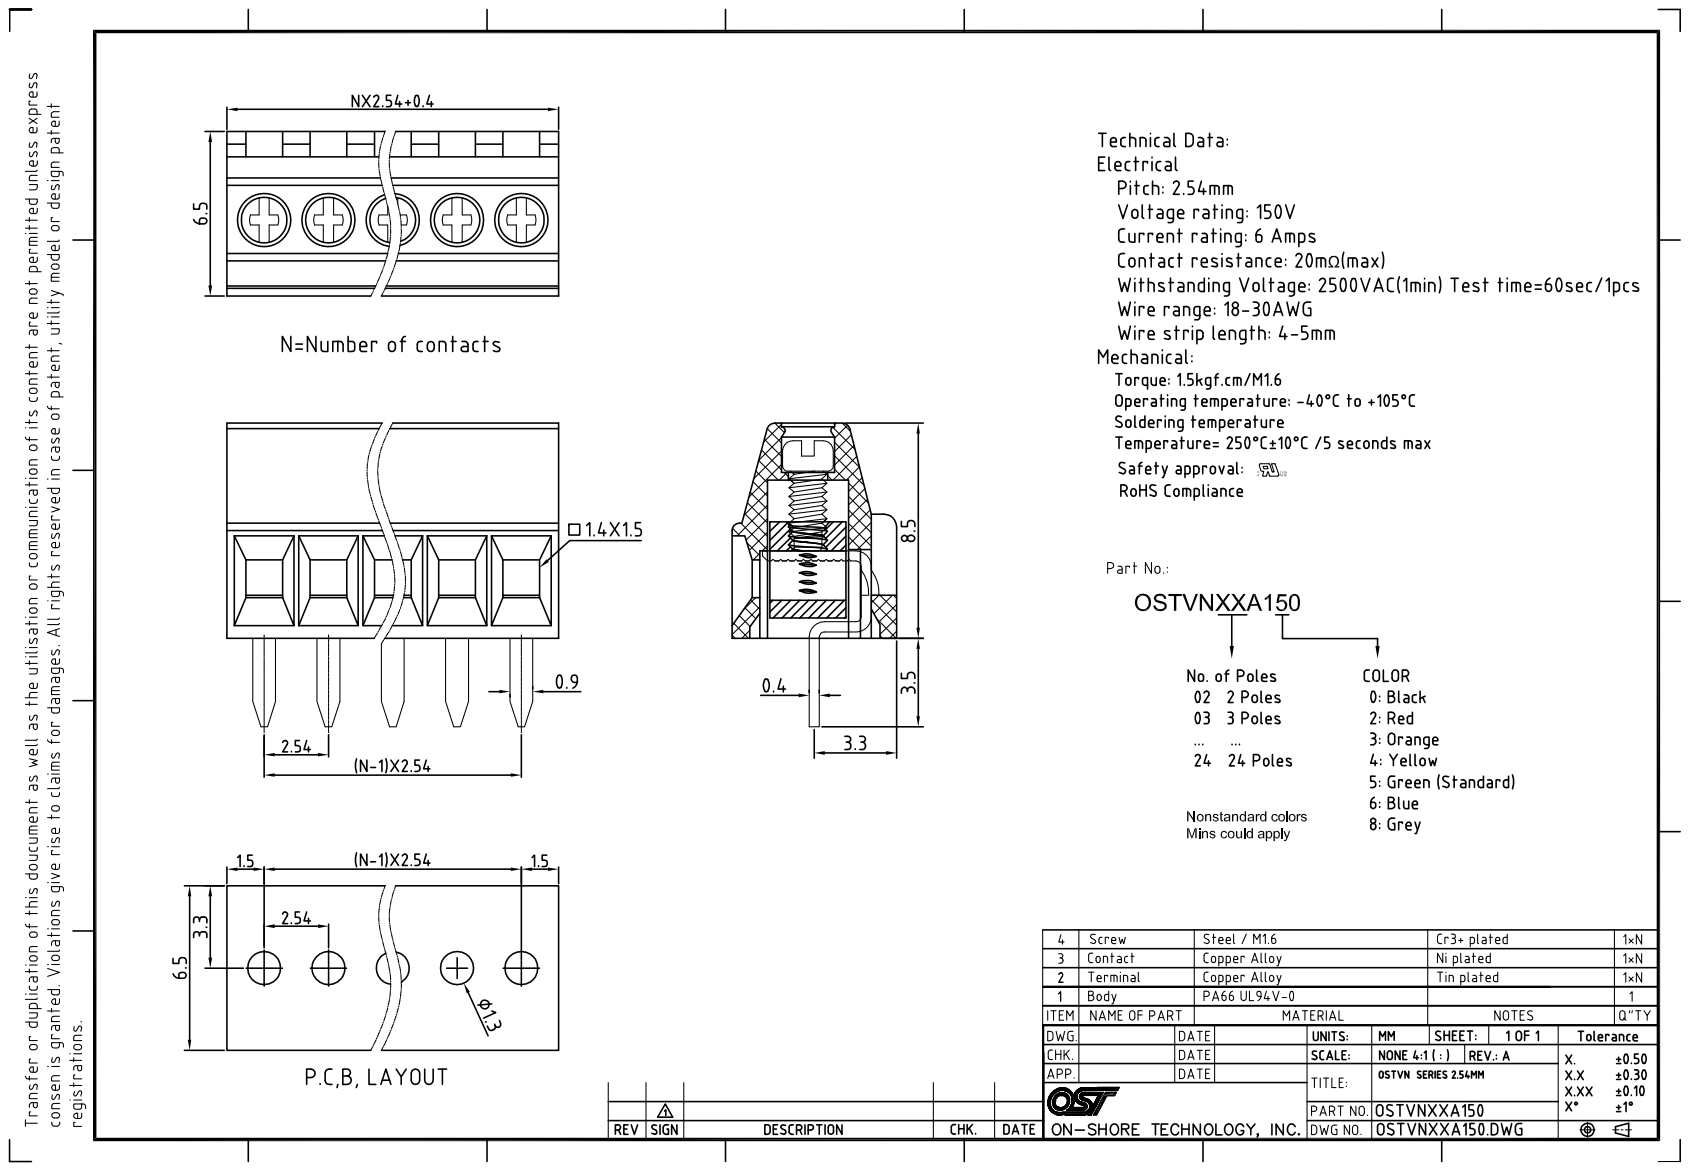
[picture p91: page 1]
