JuanCozzi/Trabajo_Final/Implementacion/Planos/Gabinete.pdf

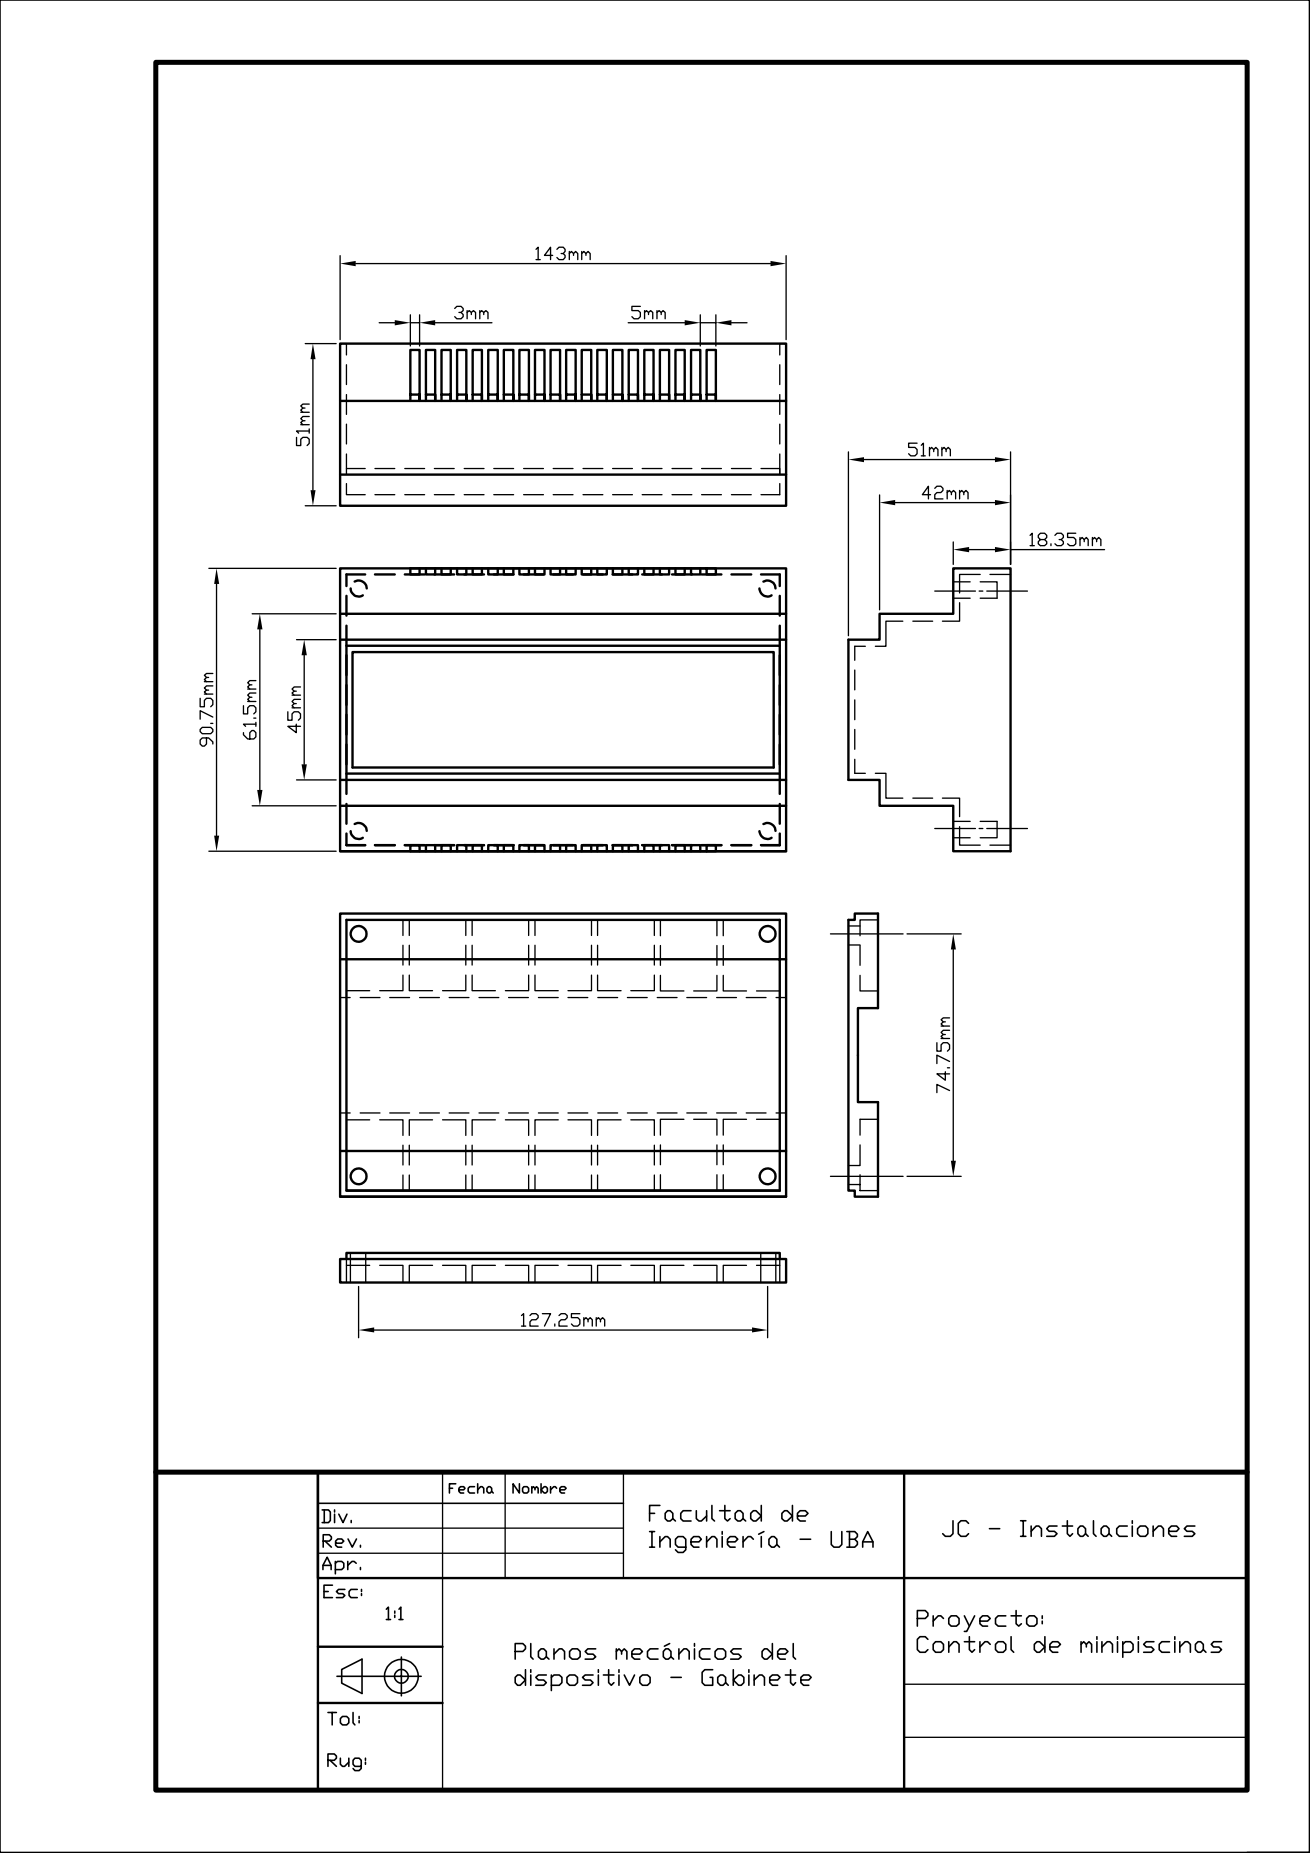
[picture p92: page 1]
