JuanCozzi/Trabajo_Final/Implementacion/Hardware/PCB/Final_1.kicad_pcb

## KiCad design Implementacion/Hardware/PCB/Final_1.kicad_pcb (2020-07-28)

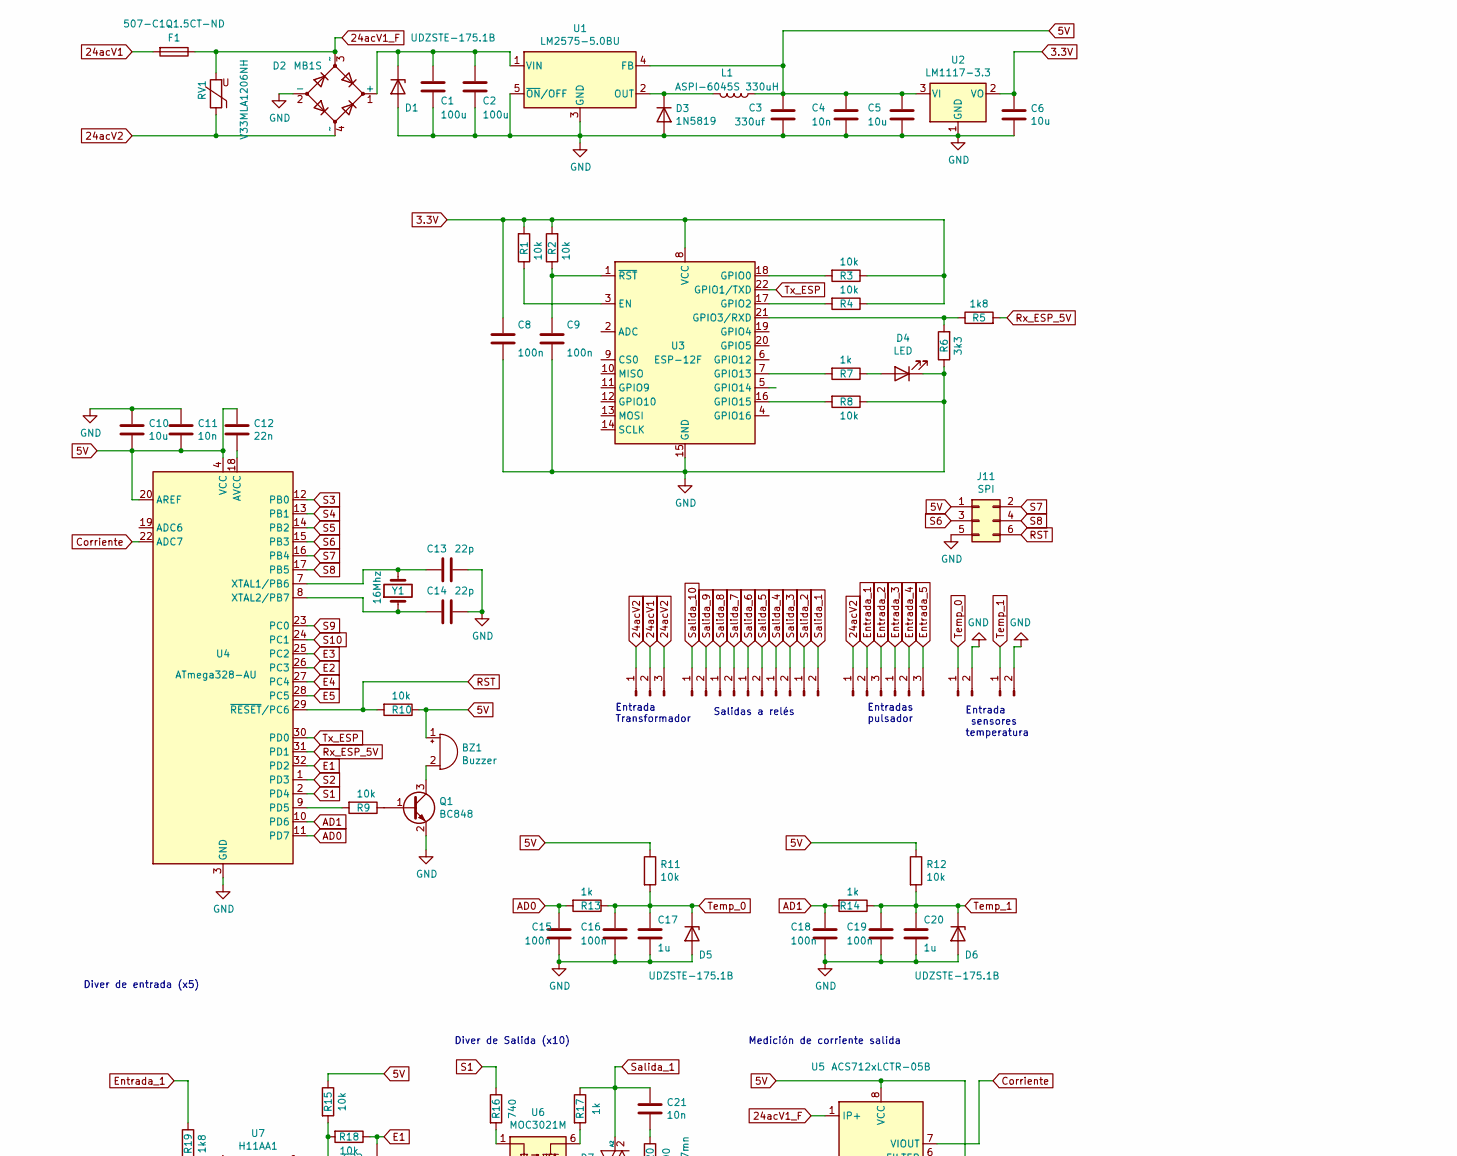
[picture p93: schematic Final_1.sch, part in row 1, column 1]

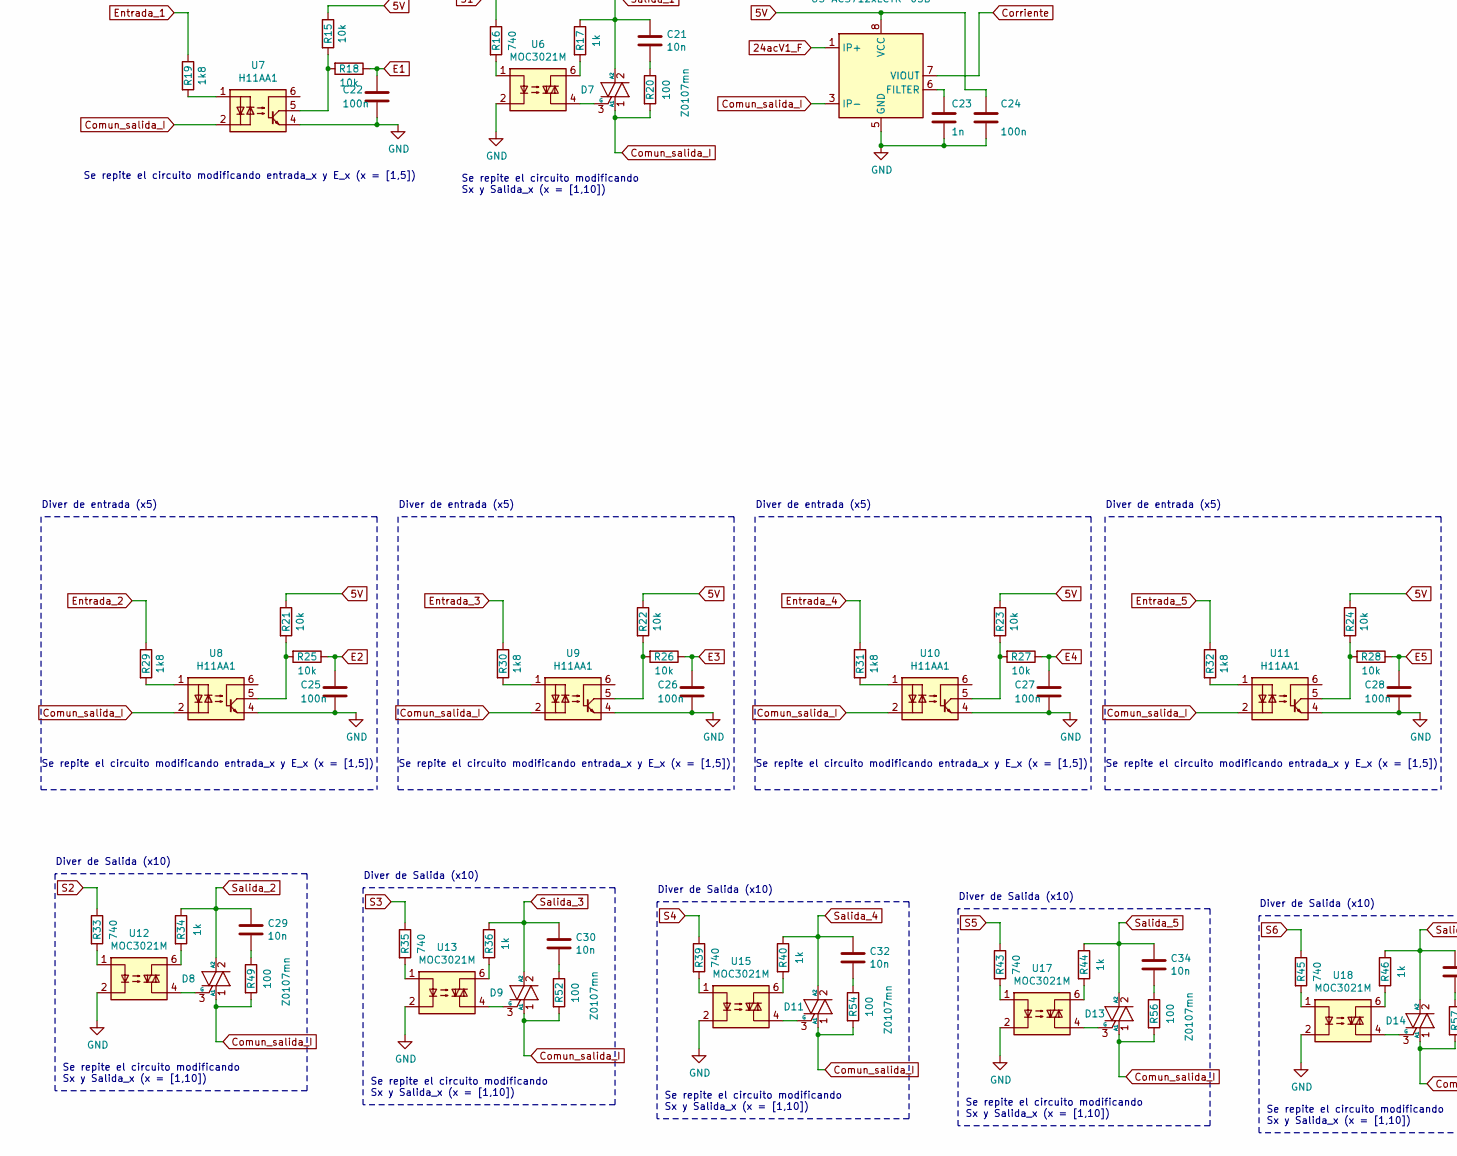
[picture p94: schematic Final_1.sch, part in row 2, column 1]

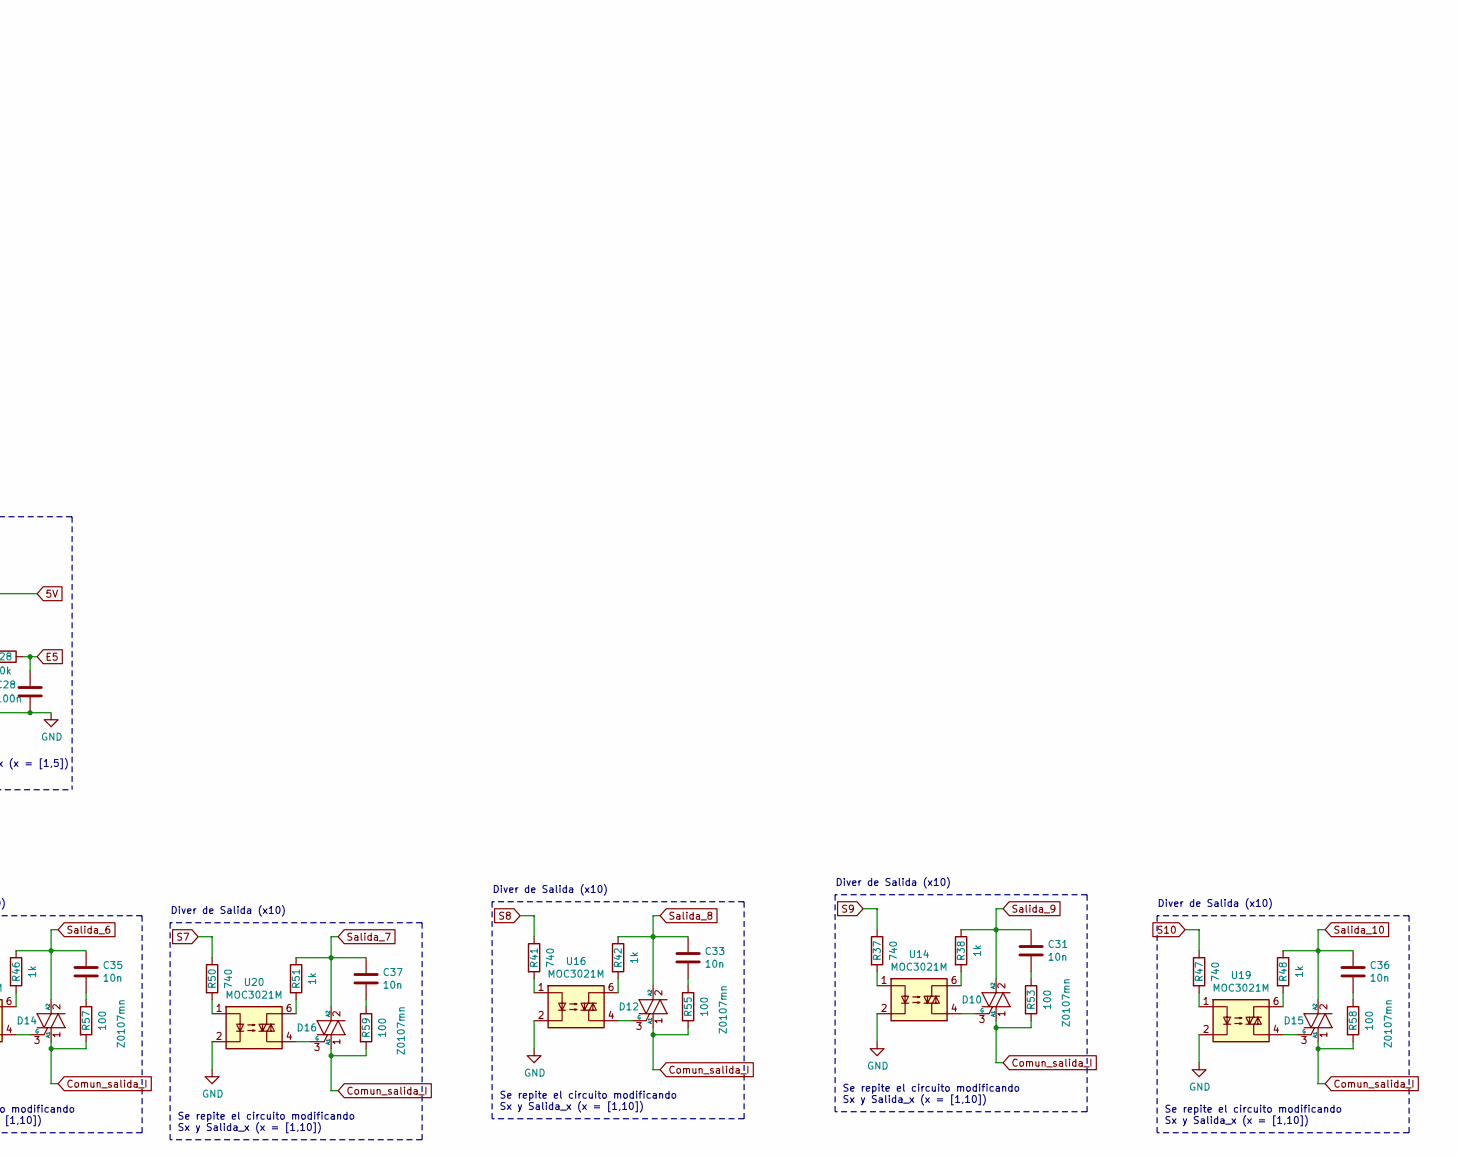
[picture p95: schematic Final_1.sch, part in row 2, column 2]

Parts:
BZ1: Buzzer; Buzzer_12x9.5RM7.6
C1, C2: 100u; CP_Elec_8x10
C3: 330uf; CP_Elec_8x10
C4, C11, C21, C29, C30, C31, C32, C33, C34, C35, C36, C37: 10n; C_0805_2012Metric
C5, C6, C10: 10u; CP_Elec_4x5.4
C8, C9, C15, C16, C18, C19, C22, C24, C25, C26, C27, C28: 100n; C_0805_2012Metric
C12: 22n; C_0805_2012Metric
C13, C14: 22p; C_0805_2012Metric
C17: 1u; C_0805_2012Metric_Pad1.15x1.40mm_HandSolder
C20: 1u; C_0805_2012Metric
C23: 1n; C_0805_2012Metric
D1, D5, D6: UDZSTE-175.1B; D_0805_2012Metric
D2: MB1S; SOIC-4_4.55x2.6mm_P1.27mm
D3: 1N5819; D_SOD-123
D4: LED; LED_0805_2012Metric
D7, D8, D9, D10, D11, D12, D13, D14, D15, D16: Z0107mn; SOT-223-3_TabPin2
F1: 507-C1Q1.5CT-ND; Fuse_Bourns_MF-RHT400
J1: Entrada; TerminalBlock_bornier-3_P5.08mm
J2: l; TerminalBlock_bornier-2_P5.08mm
J3, J4, J5, J6, J9, J10: Conn_01x02_Male; TerminalBlock_bornier-2_P5.08mm
J7: transformador; TerminalBlock_bornier-3_P5.08mm
J8: Salidas a relés; TerminalBlock_bornier-3_P5.08mm
J11: SPI; PinSocket_2x03_P2.54mm_Vertical
L1: ASPI-6045S 330uH; L_Abracon_ASPI-3012S
Q1: BC848; SOT-23
R1, R2, R3, R4, R8, R9, R10, R11, R12, R15, R18, R21, R22, R23, R24, R25, R26, R27, R28: 10k; R_0805_2012Metric
R5, R19, R29, R30, R31, R32: 1k8; R_0805_2012Metric
R6: 3k3; R_0805_2012Metric
R7, R13, R14, R17, R34, R36, R38, R40, R42, R44, R46, R48, R51: 1k; R_0805_2012Metric
R16, R33, R35, R37, R39, R41, R43, R45, R47, R50: 740; R_0805_2012Metric
R20, R49, R52, R53, R54, R55, R56, R57, R58, R59: 100; R_0805_2012Metric
RV1: V33MLA1206NH; RV_Disc_D7mm_W3.6mm_P5mm
U1: LM2575-5.0BU; TO-263-5_TabPin3
U2: LM1117-3.3; SOT-223-3_TabPin2
U3: ESP-12F; ESP-12E
U4: ATmega328-AU; TQFP-32_7x7mm_P0.8mm
U5: ACS712xLCTR-05B; SOIC-8_3.9x4.9mm_P1.27mm
U6, U12, U13, U14, U15, U16, U17, U18, U19, U20: MOC3021M; SMDIP-6_W7.62mm
U7, U8, U9, U10, U11: H11AA1; SMDIP-6_W7.62mm
Y1: 16Mhz; Crystal_SMD_7050-2Pin_7.0x5.0mm

Connections:
3.3V: C6.1, C8.1, R1.2, R2.2, R3.1, R4.1, U2.2 (VO), U3.8 (VCC)
5V: BZ1.1 (-), C3.1, C4.1, C5.1, C10.2, C11.2, C12.1, C24.1, J11.1, L1.1, R10.1, R11.1, R12.1, R15.1, R21.1, R22.1, R23.1, R24.1, U1.4 (FB), U2.3 (VI), U4.4 (VCC), U4.6 (VCC), U4.20 (AREF), U5.8 (VCC)
24acV1: F1.2, J1.2
24acV1_F: D2.3 (~~), F1.1, RV1.2, U5.1 (IP+), U5.2 (IP+)
24acV2: D2.4 (~~), J1.1, J1.3, J7.1, RV1.1
AD0: C15.1, R13.2, U4.11 (PD7)
AD1: C18.1, R14.2, U4.10 (PD6)
Comun_salida_I: D7.1 (A1), D8.1 (A1), D9.1 (A1), D10.1 (A1), D11.1 (A1), D12.1 (A1), D13.1 (A1), D14.1 (A1), D15.1 (A1), D16.1 (A1), R20.2, R49.2, R52.2, R53.2, R54.2, R55.2, R56.2, R57.2, R58.2, R59.2, U5.3 (IP-), U5.4 (IP-), U7.2, U8.2, U9.2, U10.2, U11.2
Corriente: U4.22 (ADC7), U5.7 (VIOUT)
E1: C22.1, R18.1, U4.32 (PD2)
E2: C25.1, R25.1, U4.26 (PC3)
E3: C26.1, R26.1, U4.25 (PC2)
E4: C27.1, R27.1, U4.27 (PC4)
E5: C28.1, R28.1, U4.28 (PC5)
Entrada_1: J7.2, R19.1
Entrada_2: J7.3, R29.1
Entrada_3: J8.1, R30.1
Entrada_4: J8.2, R31.1
Entrada_5: J8.3, R32.1
GND: C1.2, C2.2, C3.2, C4.2, C5.2, C6.2, C8.2, C9.2, C10.1, C11.1, C13.1, C14.1, C15.2, C16.2, C17.2, C18.2, C19.2, C20.2, C22.2, C23.2, C24.2, C25.2, C26.2, C27.2, C28.2, D1.2 (A), D2.2 (-), D3.2 (A), D4.1 (K), D5.2 (A), D6.2 (A), J9.2, J10.2, J11.5, Q1.2 (E), R6.1, R8.1, U1.3 (GND), U1.5 (~ON~/OFF), U2.1 (GND), U3.15 (GND), U4.3 (GND), U4.5 (GND), U4.21 (GND), U5.5 (GND), U6.2, U7.4, U8.4, U9.4, U10.4, U11.4, U12.2, U13.2, U14.2, U15.2, U16.2, U17.2, U18.2, U19.2, U20.2
unnamed: BZ1.2 (+), Q1.3 (C)
unnamed: C1.1, C2.1, D1.1 (K), D2.1 (+), U1.1 (VIN)
unnamed: C9.1, R2.1, U3.1 (~RST)
unnamed: C12.2, U4.18 (AVCC)
unnamed: C13.2, U4.7 (XTAL1/PB6), Y1.2
unnamed: C14.2, U4.8 (XTAL2/PB7), Y1.1
unnamed: C21.2, R20.1
unnamed: C23.1, U5.6 (FILTER)
unnamed: C29.2, R49.1
unnamed: C30.2, R52.1
unnamed: C31.2, R53.1
unnamed: C32.2, R54.1
unnamed: C33.2, R55.1
unnamed: C34.2, R56.1
unnamed: C35.2, R57.1
unnamed: C36.2, R58.1
unnamed: C37.2, R59.1
unnamed: D3.1 (K), L1.2, U1.2 (OUT)
unnamed: D4.2 (A), R7.1
unnamed: D7.3 (G), U6.4
unnamed: D8.3 (G), U12.4
unnamed: D9.3 (G), U13.4
unnamed: D10.3 (G), U14.4
unnamed: D11.3 (G), U15.4
unnamed: D12.3 (G), U16.4
unnamed: D13.3 (G), U17.4
unnamed: D14.3 (G), U18.4
unnamed: D15.3 (G), U19.4
unnamed: D16.3 (G), U20.4
unnamed: Q1.1 (B), R9.1
unnamed: R1.1, U3.3 (EN)
unnamed: R3.2, U3.18 (GPIO0)
unnamed: R4.2, U3.17 (GPIO2)
unnamed: R5.1, R6.2, U3.21 (GPIO3/RXD)
unnamed: R7.2, U3.7 (GPIO13)
unnamed: R8.2, U3.16 (GPIO15)
unnamed: R9.2, U4.9 (PD5)
unnamed: R15.2, R18.2, U7.5
unnamed: R16.2, U6.1
unnamed: R17.2, U6.6
unnamed: R19.2, U7.1
unnamed: R21.2, R25.2, U8.5
unnamed: R22.2, R26.2, U9.5
unnamed: R23.2, R27.2, U10.5
unnamed: R24.2, R28.2, U11.5
unnamed: R29.2, U8.1
unnamed: R30.2, U9.1
unnamed: R31.2, U10.1
unnamed: R32.2, U11.1
unnamed: R33.2, U12.1
unnamed: R34.2, U12.6
unnamed: R35.2, U13.1
unnamed: R36.2, U13.6
unnamed: R37.2, U14.1
unnamed: R38.2, U14.6
unnamed: R39.2, U15.1
unnamed: R40.2, U15.6
unnamed: R41.2, U16.1
unnamed: R42.2, U16.6
unnamed: R43.2, U17.1
unnamed: R44.2, U17.6
unnamed: R45.2, U18.1
unnamed: R46.2, U18.6
unnamed: R47.2, U19.1
unnamed: R48.2, U19.6
unnamed: R50.2, U20.1
unnamed: R51.2, U20.6
RST: J11.6, R10.2, U4.29 (~RESET~/PC6)
Rx_ESP_5V: R5.2, U4.31 (PD1)
S1: R16.1, U4.2 (PD4)
S2: R33.1, U4.1 (PD3)
S3: R35.1, U4.12 (PB0)
S4: R39.1, U4.13 (PB1)
S5: R43.1, U4.14 (PB2)
S6: J11.3, R45.1, U4.15 (PB3)
S7: J11.2, R50.1, U4.16 (PB4)
S8: J11.4, R41.1, U4.17 (PB5)
S9: R37.1, U4.23 (PC0)
S10: R47.1, U4.24 (PC1)
Salida_1: C21.1, D7.2 (A2), J6.2, R17.1
Salida_2: C29.1, D8.2 (A2), J6.1, R34.1
Salida_3: C30.1, D9.2 (A2), J5.2, R36.1
Salida_4: C32.1, D11.2 (A2), J5.1, R40.1
Salida_5: C34.1, D13.2 (A2), J4.2, R44.1
Salida_6: C35.1, D14.2 (A2), J4.1, R46.1
Salida_7: C37.1, D16.2 (A2), J3.2, R51.1
Salida_8: C33.1, D12.2 (A2), J3.1, R42.1
Salida_9: C31.1, D10.2 (A2), J2.2, R38.1
Salida_10: C36.1, D15.2 (A2), J2.1, R48.1
Temp_0: C16.1, C17.1, D5.1 (K), J9.1, R11.2, R13.1
Temp_1: C19.1, C20.1, D6.1 (K), J10.1, R12.2, R14.1
Tx_ESP: U3.22 (GPIO1/TXD), U4.30 (PD0)

Notes on the sheet:
Medición de corriente salida
Se repite el circuito modificando Sx y Salida_x (x = [1,10])
Se repite el circuito modificando entrada_x y E_x (x = [1,5])
Diver de entrada (x5)
Diver de Salida (x10)
Entradas pulsador
Entrada sensores temperatura
Salidas a relés
Entrada Transformador

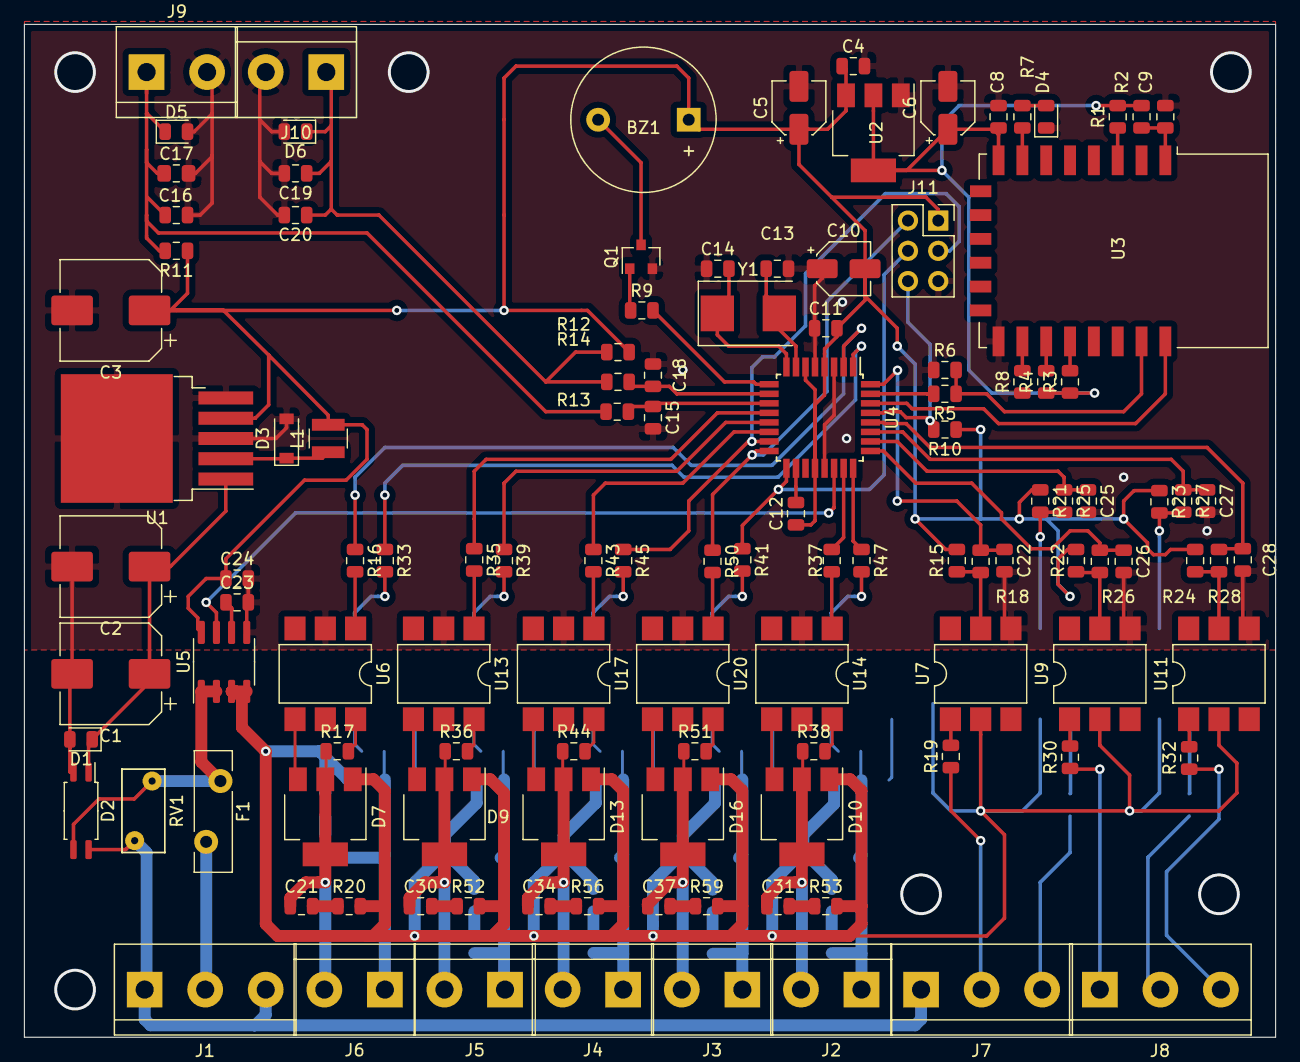
[picture p96: board Final_1.kicad_pcb from above]

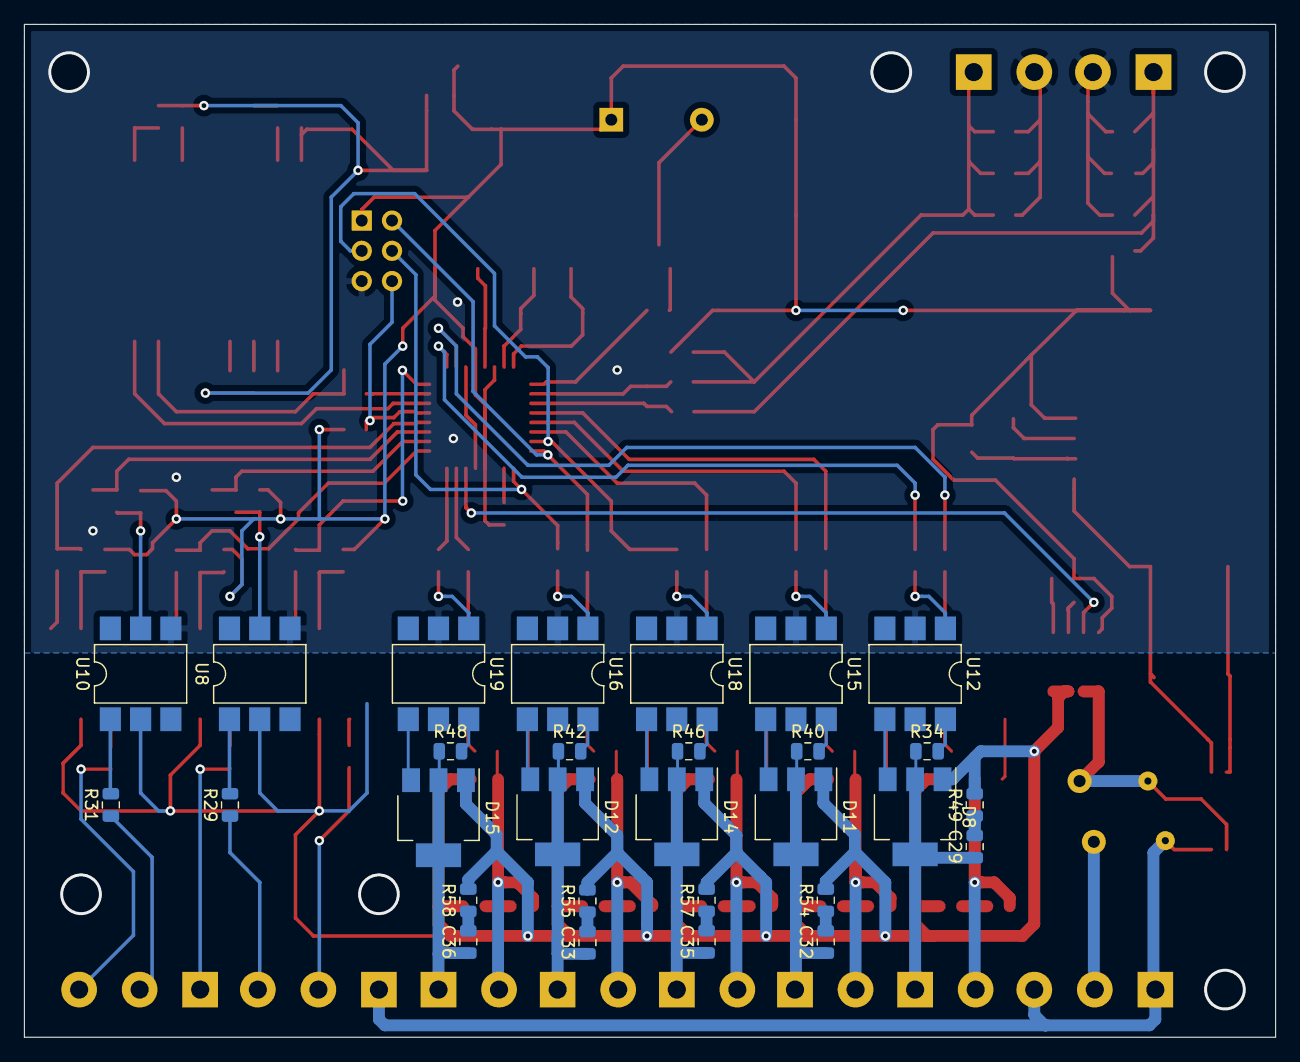
[picture p97: board Final_1.kicad_pcb from below]

Board: 2 copper layers, 105.0 x 85.0 mm, 148 parts (29 on the bottom side), 112 nets.
