JuanCozzi/Trabajo_Final/Implementacion/Hardware/PCB/Prototipo_1.kicad_pcb

## KiCad design Implementacion/Hardware/PCB/Prototipo_1.kicad_pcb (2020-07-24)

Schematic: Prototipo_1.sch

Parts:
BZ1: Buzzer; Buzzer_12x9.5RM7.6
C1: 100u; CP_Elec_8x10
C3: 330uf; CP_Elec_8x10
C4, C8, C27, C29, C30, C31, C32, C33, C34, C35, C36: 10n; C_0805_2012Metric
C5, C7, C10, C37: 10u; CP_Elec_4x5.4
C6, C11, C14, C15, C17, C18, C22, C28: 100n; C_0805_2012Metric
C9: 22n; C_0805_2012Metric
C12, C13: 22p; C_0805_2012Metric
C16, C19: 1u; CP_Elec_4x5.4
C20, C23, C24, C25, C26: 10u; C_0805_2012Metric
C21: 1n; C_0805_2012Metric
D1: D_Bridge_-A+A; Diode_Bridge_Bourns_CD-DF4xxS
D2: 1N5819; D_2010_5025Metric_Pad1.52x2.65mm_HandSolder
D3: LED; D_0805_2012Metric
D4, D5: UDZSTE-175.1B; D_SOT-23_ANK
D6, D7, D8, D9, D10, D11, D12, D13, D14: 1N4007smd; D_SMA
D15: UDZSTE-175.1B; D_0805_2012Metric
F1: 507-C1Q1.5CT-ND; fuse
J1, J2, J3, J4, J5, J6, J7, J8, J9, J10, J11: Conn_01x02_Male; TerminalBlock_bornier-2_P5.08mm
J12: Conn_01x02_Male; PinSocket_1x02_P2.54mm_Vertical
L1: ASPI-6045S 330uH; L_12x12mm_H6mm
Q1: BC848; SOT-23
Q2, Q3, Q4, Q5, Q6, Q7, Q8, Q9, Q10: MMBT3906; SOT-23
R1, R8, R9, R13, R14, R24, R26, R28, R30, R32, R33, R34, R35, R36, R37, R39, R41, R43, R46, R47, R48: 1k; R_0805_2012Metric
R2, R10, R15, R17, R19, R21: 1k8; R_0805_2012Metric
R3: 3k3; R_0805_2012Metric
R4, R5, R6, R7, R11, R16, R18, R20, R22, R50, R51, R52, R53, R54: 10k; R_0805_2012Metric
R12, R23, R25, R27, R29, R31, R38, R40, R42: 740; R_0805_2012Metric
RV1: V33MLA1206NH; RV_Disc_D7mm_W3.4mm_P5mm
U1: LM2596S-ADJ; TO-263-5_TabPin3
U2: NodeMCU; DIP-30_1090_ELL
U3: ATmega328-PU; DIP-28_W7.62mm_LongPads
U4: ACS712xLCTR-05B; SOIC-8_3.9x4.9mm_P1.27mm
U5, U6, U7, U8, U9, U10, U11, U12, U13, U14, U15, U16, U17, U18: EL817; DIP-4_W7.62mm_LongPads
Y1: 16Mhz; Crystal_HC49-U_Vertical

Connections:
5V: BZ1.1 (-), C3.1, C4.1, C7.2, C8.2, C9.1, C10.1, C11.1, C22.1, L1.1, R5.1, R6.1, R7.1, R11.1, R16.1, R18.1, R20.1, R22.1, U1.4, U2.15, U3.7, U3.21, U4.1 (IP+), U4.2 (IP+), U4.8 (VCC)
24acV1: F1.2, J6.1
24acV1_F: D1.4, F1.1, RV1.2, U6.2, U7.2, U8.2, U9.2, U10.2
24acV2: D1.2, J6.2, RV1.1
A0: C14.1, R8.2, U3.27
A1: C17.1, R9.2, U3.28
Comun_salida_i: C28.1, C37.1, D6.1 (K), D7.1 (K), D8.1 (K), D9.1 (K), D10.1 (K), D11.1 (K), D12.1 (K), D13.1 (K), D14.1 (K), Q2.2, Q3.2, Q4.2, Q5.2, Q6.2, Q7.2, Q8.2, Q9.2, Q10.2, R14.1, R33.1, R34.1, R35.1, R36.1, R37.1, R46.1, R47.1, R48.1, U4.3 (IP-), U4.4 (IP-)
Corriente: U3.26, U4.7 (VIOUT)
E1: C20.2, R50.1, U3.12
E2: C23.2, R52.1, U3.13
E3: C24.2, R53.1, U3.14
E4: C25.2, R51.1, U3.15
E5: C26.2, R54.1, U3.16
Entrada_1: J7.2, R10.1
Entrada_2: J8.1, R15.1
Entrada_3: J8.2, R17.1
Entrada_4: J9.1, R19.1
Entrada_5: J9.2, R21.1
GND: C1.2, C3.2, C4.2, C5.2, C6.2, C7.1, C8.1, C10.2, C11.2, C12.1, C13.1, C14.2, C15.2, C16.2, C17.2, C18.2, C19.2, C20.1, C21.2, C22.2, C23.1, C24.1, C25.1, C26.1, C27.1, C28.2, C29.1, C30.1, C31.1, C32.1, C33.1, C34.1, C35.1, C36.1, C37.2, D1.1, D2.2 (A), D4.2 (A), D5.2 (A), D15.2 (A), J1.1, J10.2, J11.2, Q1.2 (E), R1.1, R3.1, U1.3, U1.5, U2.2, U2.10, U2.14, U2.17, U2.24, U3.8, U3.22, U4.5 (GND), U5.2, U5.3, U6.3, U7.3, U8.3, U9.3, U10.3, U11.2, U11.3, U12.2, U12.3, U13.2, U13.3, U14.2, U14.3, U15.2, U15.3, U16.2, U16.3, U17.2, U17.3, U18.2, U18.3
unnamed: BZ1.2 (+), Q1.3 (C)
unnamed: C1.1, D1.3, D15.1 (K), U1.1
unnamed: C5.1, C6.1, U2.11
unnamed: C9.2, U3.20
unnamed: C12.2, U3.9, Y1.2
unnamed: C13.2, U3.10, Y1.1
unnamed: C21.1, U4.6 (FILTER)
unnamed: D2.1 (K), L1.2, U1.2
unnamed: D3.1 (K), R1.2
unnamed: D3.2 (A), U2.4
unnamed: Q1.1 (B), R4.1
unnamed: Q2.1, R13.1
unnamed: Q3.1, R24.1
unnamed: Q4.1, R26.1
unnamed: Q5.1, R28.1
unnamed: Q6.1, R30.1
unnamed: Q7.1, R32.1
unnamed: Q8.1, R39.1
unnamed: Q9.1, R41.1
unnamed: Q10.1, R43.1
unnamed: R2.1, R3.2, U2.19
unnamed: R4.2, U3.11
unnamed: R5.2, U3.1
unnamed: R10.2, U6.1
unnamed: R11.2, R50.2, U6.4
unnamed: R12.2, U5.1
unnamed: R13.2, R14.2, U5.4
unnamed: R15.2, U7.1
unnamed: R16.2, R52.2, U7.4
unnamed: R17.2, U8.1
unnamed: R18.2, R53.2, U8.4
unnamed: R19.2, U9.1
unnamed: R20.2, R51.2, U9.4
unnamed: R21.2, U10.1
unnamed: R22.2, R54.2, U10.4
unnamed: R23.2, U11.1
unnamed: R24.2, R33.2, U11.4
unnamed: R25.2, U12.1
unnamed: R26.2, R34.2, U12.4
unnamed: R27.2, U13.1
unnamed: R28.2, R35.2, U13.4
unnamed: R29.2, U14.1
unnamed: R30.2, R36.2, U14.4
unnamed: R31.2, U15.1
unnamed: R32.2, R37.2, U15.4
unnamed: R38.2, U16.1
unnamed: R39.2, R46.2, U16.4
unnamed: R40.2, U17.1
unnamed: R41.2, R47.2, U17.4
unnamed: R42.2, U18.1
unnamed: R43.2, R48.2, U18.4
Rx_ESP_5V: J12.1, R2.2, U3.3
S1: R12.1, U3.4
S2: R23.1, U3.5
S3: R25.1, U3.6
S4: R27.1, U3.25
S5: R29.1, U3.24
S6: R31.1, U3.23
S7: R38.1, U3.19
S8: R40.1, U3.18
S9: R42.1, U3.17
Salida_1: C27.2, D6.2 (A), J5.2, Q2.3
Salida_2: C29.2, D7.2 (A), J5.1, Q3.3
Salida_3: C30.2, D8.2 (A), J4.2, Q4.3
Salida_4: C31.2, D9.2 (A), J4.1, Q5.3
Salida_5: C32.2, D10.2 (A), J3.2, Q6.3
Salida_6: C33.2, D11.2 (A), J3.1, Q7.3
Salida_7: C34.2, D12.2 (A), J2.2, Q8.3
Salida_8: C35.2, D13.2 (A), J2.1, Q9.3
Salida_9: C36.2, D14.2 (A), J1.2, Q10.3
Temp_0: C15.1, C16.1, D4.1 (K), J10.1, R6.2, R8.1
Temp_1: C18.1, C19.1, D5.1 (K), J11.1, R7.2, R9.1
Tx_ESP: J12.2, U2.18, U3.2

Notes on the sheet:
Medición de corriente salida
Se repite el circuito modificando Sx y Salida_x (x = [1,10])
Se repite el circuito modificando entrada_x y E_x (x = [1,5])
Diver de entrada (x5)
Diver de Salida (x10)

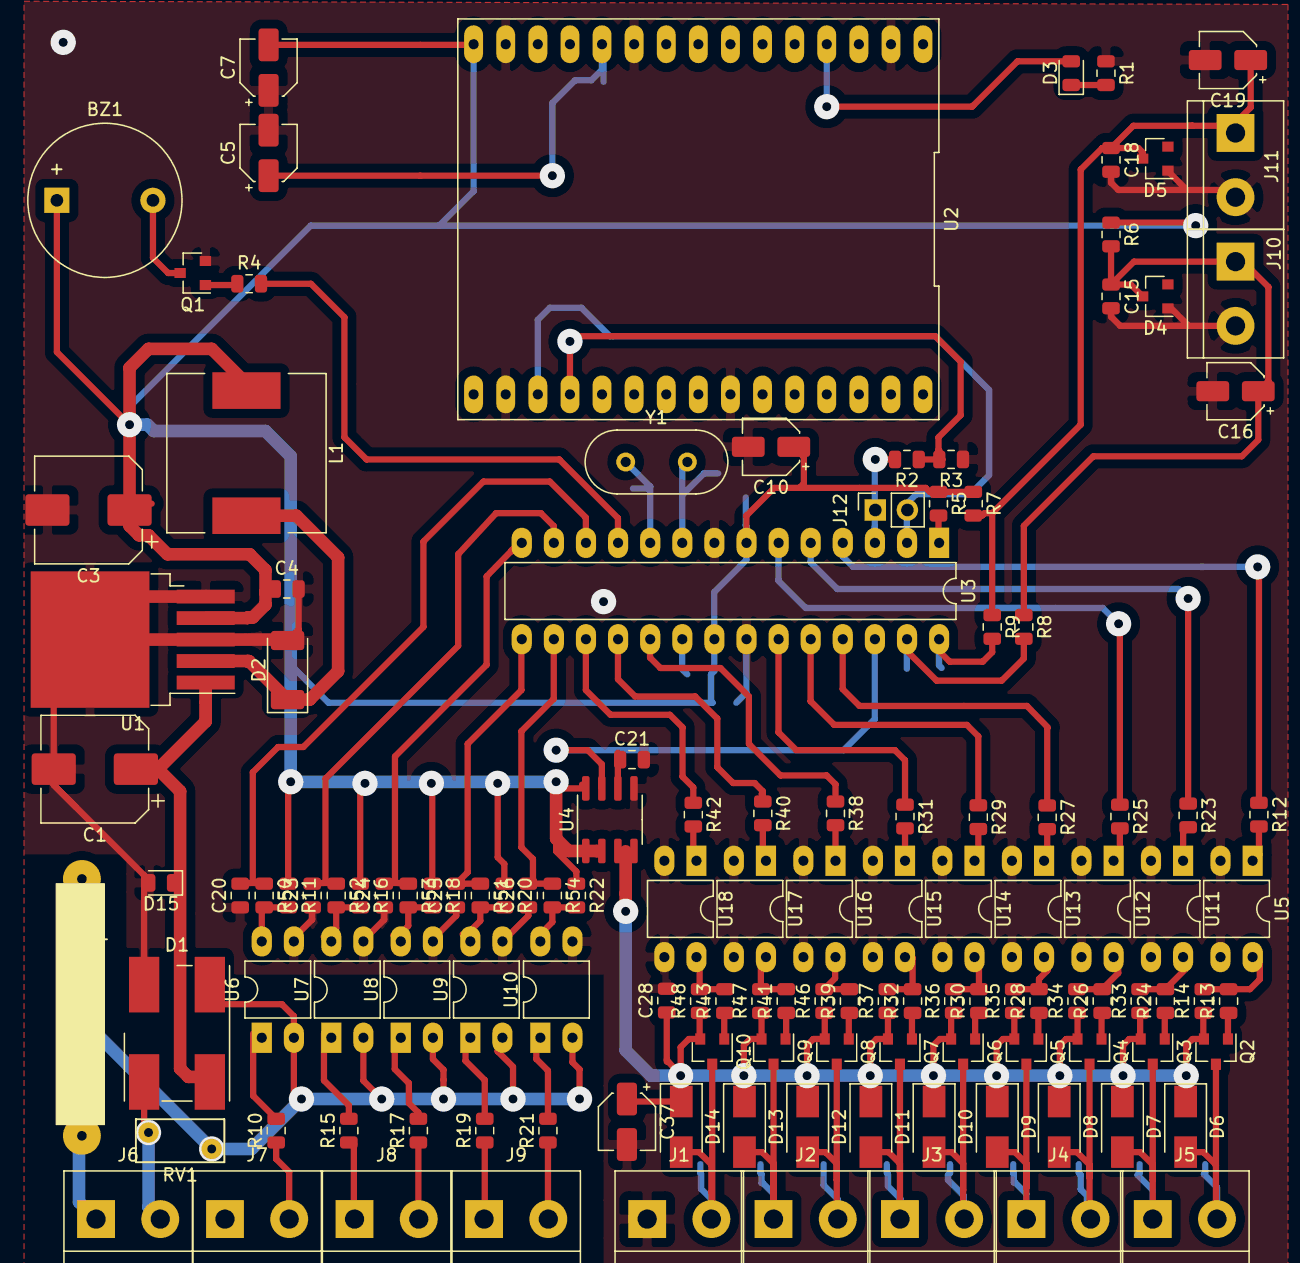
[picture p98: board Prototipo_1.kicad_pcb from above]

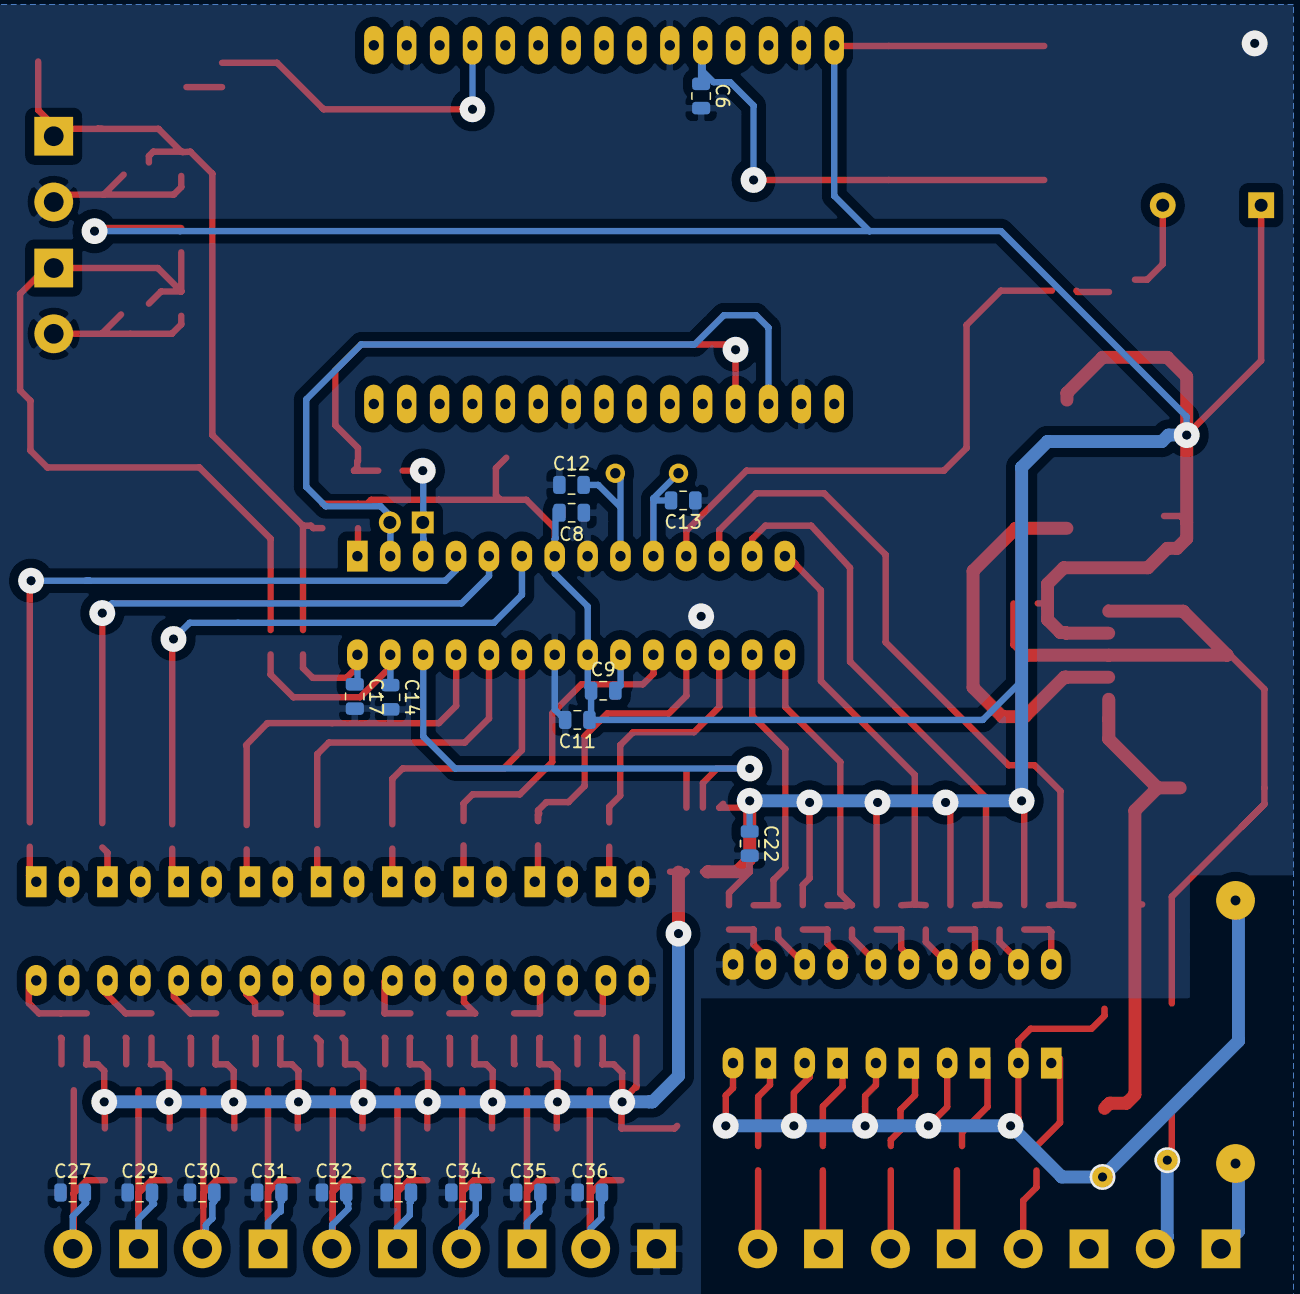
[picture p99: board Prototipo_1.kicad_pcb from below]

Board: 2 copper layers, 147 parts (18 on the bottom side), 92 nets.
