JuanCozzi/Trabajo_Final/(commit log)

2020-07-24 Planos gabinete
    [Gabinete.dwg]
2020-07-25 Esquematicos y PCB
    [Final_1.kicad_pcb, Final_1.sch, TP.kicad_pcb, TP.sch]
2020-07-26 Planos montaje
    [Final_1.kicad_pcb, Gabinete.dwg, Montaje.dwg, PCB.dwg]
2020-07-28 Actualización pcb
    [Final_1.kicad_pcb, Final_1.sch]
2020-08-15 Implementación inicial del webserver con muchos prints de debug (muchos), y un mock de dispositivo con autenticación para el ESP.
    [Final_1.kicad_pcb, Final_1.sch, Gabinete.dwg, Montaje.dwg, PCB.dwg, Prototipo_1.kicad_pcb, Prototipo_1.sch]
2020-08-15 Agregado campo indicando nombre descriptivo para las salidas.
2020-08-16 Agregado el nombre descriptivo de las salidas al dashboard de los dispositivos.
2020-08-16 Ahora el mock de dispositivo verifica si está autenticado antes de intentar la conexión del websocket.
2020-08-25 Agregadas alertas de información y error en la página web. También se agregó un programa para el ESP para probar los mensajes de forma sencilla.
    [consumers.py, device_mock_error_testing.ino]
2020-08-25 Agregados los diagramas de flujo de la unidad principal y de comunicación.
2020-08-27 Manual de instalación y operación
    avances
2020-09-12 Agregados templates para cambio de contraseña. También botón para desasociar dispositivo.
2020-09-12 Cambio en ID de dispositivo. Actualizado diagrama de secuencia.
2020-09-26 Implementación preliminar del mecanismo de desvinculación.
2020-09-26 Cambio en la implementación del proceso de desvinculación del dispositivo y emprolijamiento del código de la unidad de comunicación.
2020-09-28 Interfaz gráfica de la unidad de comunicación finalizada.
2020-10-06 Agregado reset y cambio de contraseña.
    [urls.py]
2020-10-15 Agregado chequeo de permisos.
2020-10-17 Alerta de debug para datos de usuario en ESP.
